rc-earnest/BloodHound/RemoteTest/Universal Remote Control Test Software/Universal Remote Control Test Software/Resources/URC Case-1.png

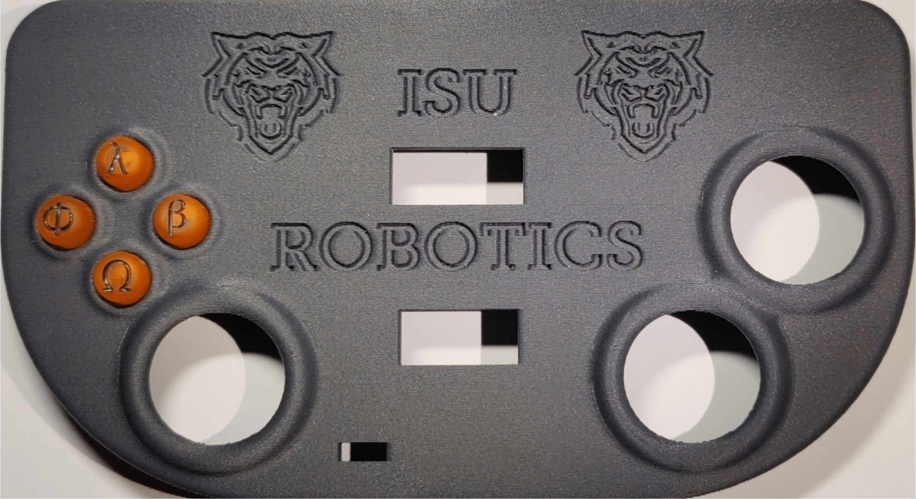
RemoteTest/Universal Remote Control Test Software/Universal Remote Control Test Software/Resources/URC Case-1.png
