rc-earnest/BloodHound/RemoteTest/Universal Remote Control Test Software/Universal Remote Control Test Software/Resources/URC PCB-1.png

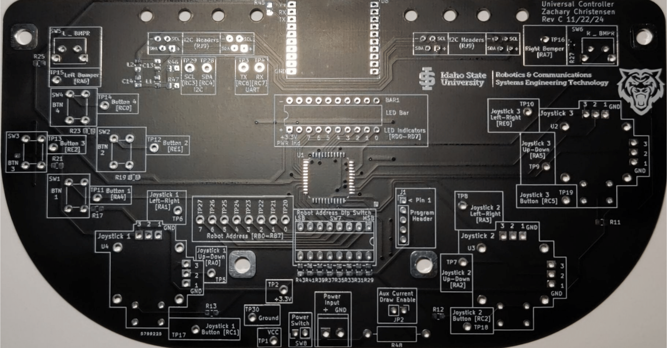
RemoteTest/Universal Remote Control Test Software/Universal Remote Control Test Software/Resources/URC PCB-1.png
