rc-earnest/BloodHound/README.md

Please read all of the READ files within the various folders as they may contain information as to what files you need to grab in the future.
