rc-earnest/BloodHound/Documents/Bloodhound_RCEV_Presentation.pptx

BloodHound RCEV

Remotely Controlled Electric Vehicle

Noah Holloway & Micah Spencer | ISU RCET Capstone | Spring 2026

[IMAGE: Bloodhound ATV photo]

## Slide 2

INTRODUCTION

What is the Bloodhound?

- A repurposed Kawasaki 450 ATV frame converted into a remotely controlled electric vehicle
- Designed to operate in hazardous environments — without putting a human operator at risk
- Powered by a 52V LiFePO4 battery with dual 48V brushless hub motors (front-wheel drive)
- Steering is handled by a DOCYKE power steering servo mounted directly to the steering column
- Built and tested in 8 weeks as an ISU RCET capstone project

[IMAGE: Bloodhound frame/hardware photo from lab]

[IMAGE: Bloodhound frame/hardware photo]

## Slide 3

HARDWARE

Hardware Overview

Vehicle Platform

- Kawasaki 450 frame, suspension & wheels
- 2× 48V brushless hub motors
- 2× 2-mode brushless speed controllers
- DOCYKE S350 power steering servo (12–18 Nm torque)

Electronics

- 52V LiFePO4 battery with BMS (30Ah)
- DC/DC converter: 52V → 24V for servo & boards
- 3 custom PCBs: URC, Master Main Board, Slave Dev Board
- All PIC16F1788 / PIC16LF1789 microcontrollers

[IMAGE: Photo of all 3 PCBs side by side, or mounted on vehicle panel]

## Slide 4

SYSTEM ARCHITECTURE

Three-Board Architecture

URC

Universal Remote Controller
PIC16LF1789 (44-pin)

MASTER

Master Main Board
PIC16F1788 (28-pin)

SLAVE

Slave Dev Board
PIC16F1788 (28-pin)

UART 115,200 bps Wireless

I2C 100 kHz Wired

Outputs from Slave Board:

PWM → Motor Controllers

PWM → DOCYKE Servo (steering)

Brake & Direction signals

[IMAGE: Block diagram from report, or photo of wired boards together]

## Slide 5

COMMUNICATION

How Data Flows: URC → Master → Slave

- Step 1 — Operator moves joystick on the URC
Joystick position captured as 0–255 analog value; packaged into a 6-byte UART packet
- Step 2 — Packet travels over wireless UART at 115,200 bps to the Master board
Packet includes: sync byte (0x24), robot address, command type, and 3 data bytes
- Step 3 — Master decodes the packet and every 96ms sends I2C data to the Slave
I2C transaction: START → address (0x20) → 4 data bytes → ACK each → STOP
- Step 4 — Slave receives I2C bytes, interprets joystick values, and updates outputs
After all 4 bytes arrive, I2C_RX_COMPLETE flag triggers motor and servo updates

## Slide 6

COMMUNICATION DEEP DIVE

I2C Data Packets Explained

Byte 1

JOY1_UD

Drive Throttle
(Joystick 1 Up/Down)

Byte 2

JOY1_LR

Unused
(future use)

Byte 3

JOY2_UD

Brake trigger
(Joystick 2 Up/Down)

Byte 4

JOY2_LR

Steering
(Joystick 2 Left/Right)

How the values are interpreted:

- Each joystick axis arrives as a byte: 0 = full left/back, 128 = center, 255 = full right/forward
- Slave compares values to thresholds (Upper: 160, Lower: 80) to determine direction
- Values outside the deadband are mapped proportionally to motor duty cycle or servo position

## Slide 7

FIRMWARE DEEP DIVE

Slave Board: Data → Physical Action

- Timer 2 ISR fires every 0.1ms — the heartbeat of all output signals
Software PWM: counts ticks to generate precise pulse widths for servo and motor controllers
- Servo (DOCYKE): 50Hz signal, 1.2ms = full right, 1.5ms = center, 1.9ms = full left
- Motor controllers: PWM duty sets speed; separate direction and brake pins control mode
- Each I2C packet triggers UPDATE_DRIVE_STATUS → threshold check → set motor duty + servo
- No I2C for ~260ms? → I2C_COM_TIMEOUT fires → brakes engage, all outputs go to stop

[IMAGE: Oscilloscope screenshot of PWM signal on RA4 (servo) or RA0 (motor)]

## Slide 8

SAFETY

Built-In Safety: Two Watchdogs

UART Watchdog (Master)

- Timer 2 counts time between valid UART packets
- No packet in ~0.5 seconds → CONNECT_TIMEOUT
- Triggers a controller disconnect routine
- Protects against loss of wireless signal

I2C Watchdog (Slave)

- Timer 1 counts time between I2C data packets
- No packet in ~260ms → I2C_COM_TIMEOUT
- Immediately engages brakes and stops all motors
- Prevents runaway if Master board fails

[IMAGE: Oscilloscope capture showing brake signal asserting after cable pull]

## Slide 9

RESULTS

What We Achieved

- Reliable wireless UART communication between URC and Master board
- Full I2C communication chain: Master → Slave, 4-byte packets at 96ms intervals
- Joystick-controlled forward and reverse drive on both hub motors
- Proportional steering via DOCYKE servo responding to joystick input
- Electronic braking — I2C timeout automatically engages brakes within 260ms
- System recovers automatically when connection is restored (no reboot needed)
- RTK GPS module started — partially functional (requires further tuning)

[IMAGE: Bloodhound being driven in the lab — action shot if available]

## Slide 10

CONCLUSION

Future Expansion & Takeaways

Planned Additions

- Front camera + backup camera (auto-switch on reverse)
- Remotely-controlled headlights via button on URC
- IMU / accelerometer for orientation data
- LiDAR for obstacle detection
- Chemical sensors: CO and CO2 detection
- RTK GPS for precise positioning

Key Takeaways

- Modular architecture — adding new slave boards is simple by design
- Hardware bugs (missing MOSFETs, wrong T2CON) can look like firmware issues
- Version control matters — working code was lost to an external tool and had to be restored
- A structured troubleshooting procedure saved significant time

Thank you — Questions?
