rc-earnest/BloodHound/Documents/Drive Report and Presentation/Bloodhound_RCEV_Presentation.pdf

# BloodHound RCEV

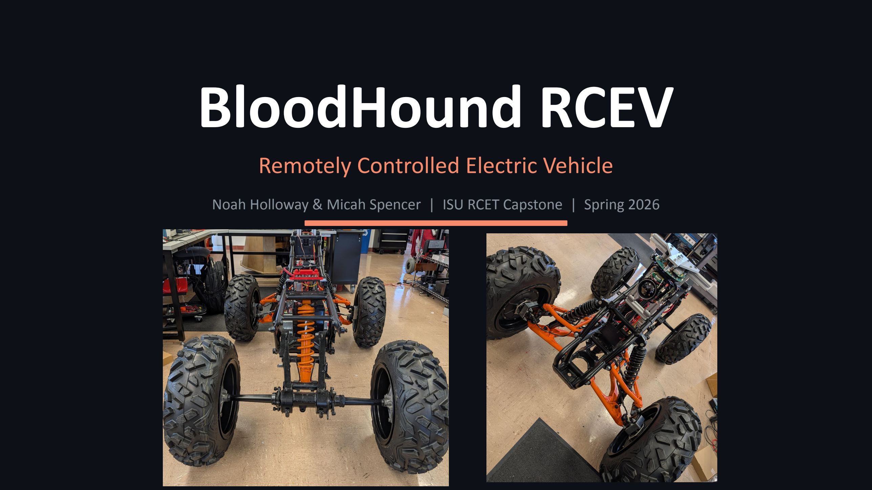
[picture p3: page 1]

## Remotely Controlled Electric Vehicle

Noah Holloway & Micah Spencer | ISU RCET Capstone | Spring 2026

# What is the Bloodhound?

- A repurposed Kawasaki 450 ATV frame converted into a Remotely Controlled Electric Vehicle (RCEV)
- Designed to operate in hazardous environments without putting a human operator at risk
- Powered by a 52V LiFePO4 battery with dual 48V brushless hub motors (front-wheel drive)
- Steering is handled by a DOCYKE power steering servo mounted directly to the steering column

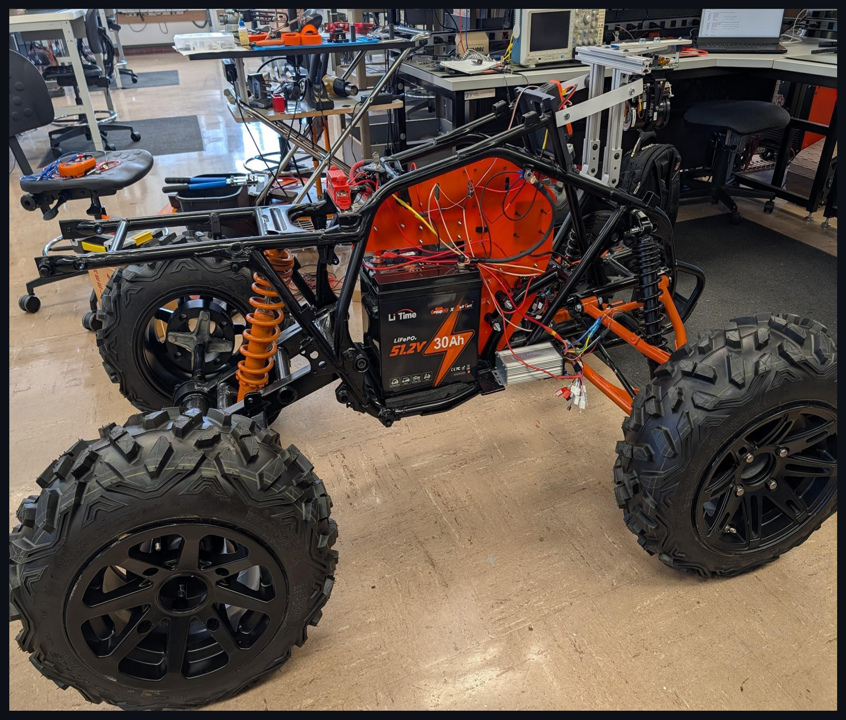
[picture p4: figure]

[IMAGE: Bloodhound frame/hardware photo from lab]

# Hardware Overview

Vehicle Platform
- Kawasaki 450 frame, suspension & wheels

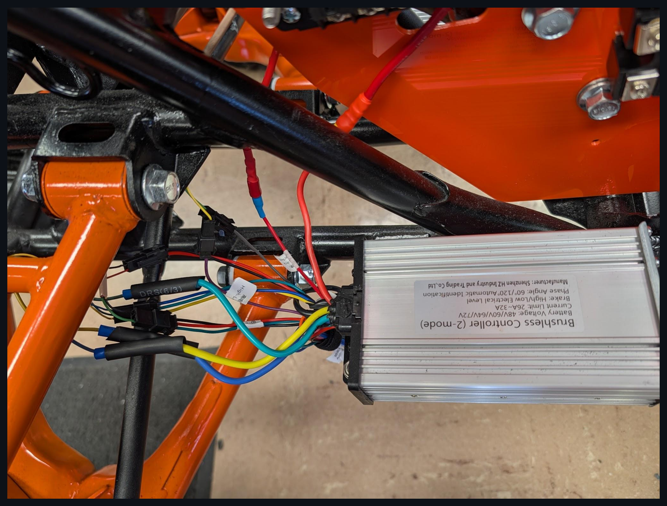
[picture p5: figure]

- 2× 48V brushless hub motors
- 2× 2-mode brushless speed controllers
- DOCYKE S350 power steering servo

Electronics
- 52V LiFePO4 battery (30Ah)
- DC/DC converter: 52V → 24V for servo & 5V step

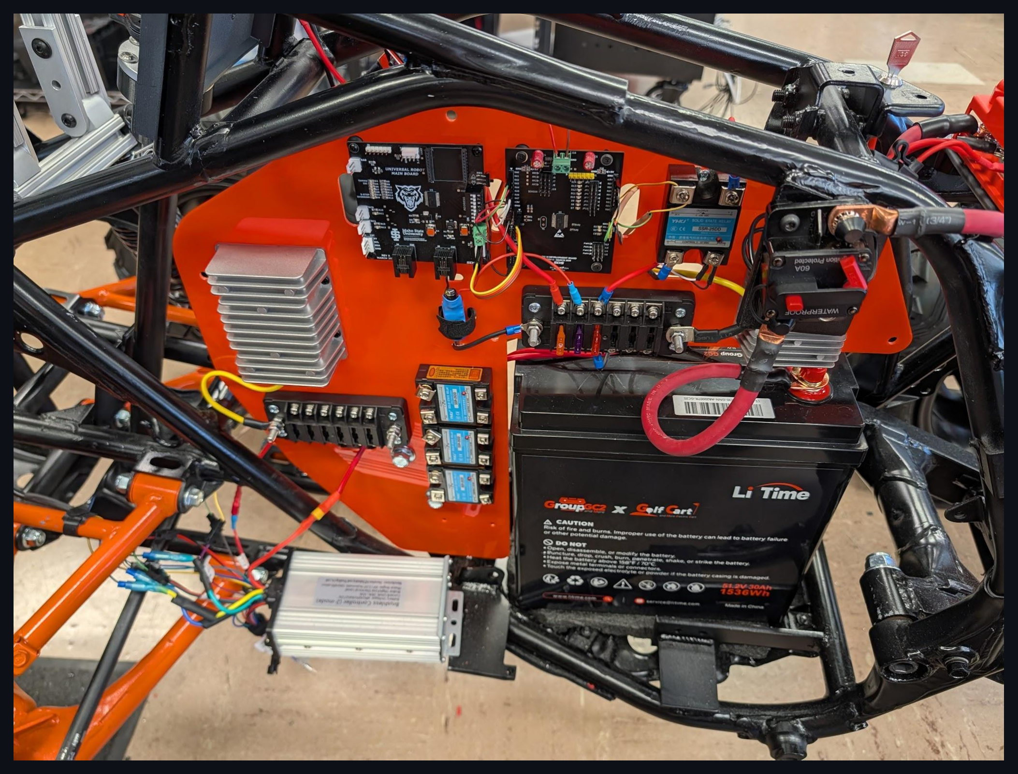
[picture p6: figure]

- DC/DC converter: 52V → 12V for headlights
- 3 custom PCBs: URC, Master Main Board, Slave Dev Board
- All PIC16F1788 / PIC16LF1789 microcontrollers

# RTK Hardware

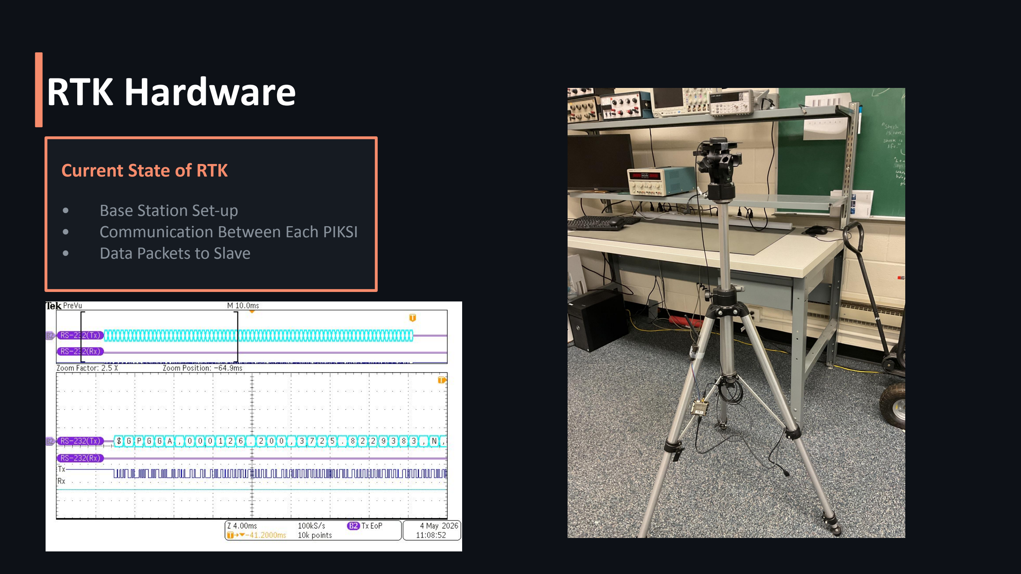
[picture p7: page 4]

Current State of RTK

- Base Station Set-up
- Communication Between Each PIKSI
- Data Packets to Slave

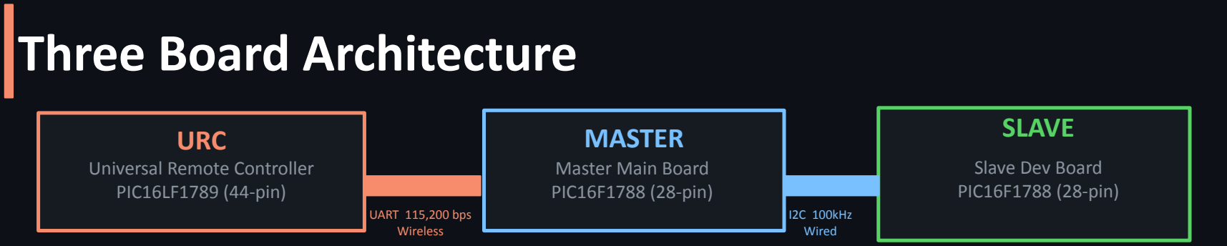
[picture p8: figure]
Three Board Architecture; URC; Universal Remote Controller PIC16LF1789 (44-pin); MASTER; Master Main Board PIC16F1788 (28-pin); SLAVE; Slave Dev Board PIC16F1788 (28-pin); UART 115,200 bps Wireless; I2C 100kHz Wired
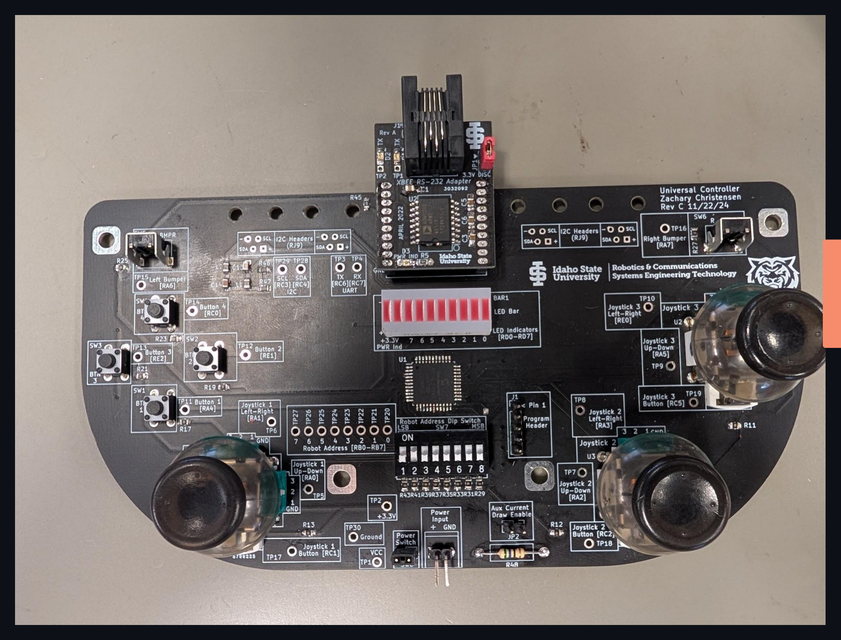
[picture p9: figure]

Outputs from Slave Board:

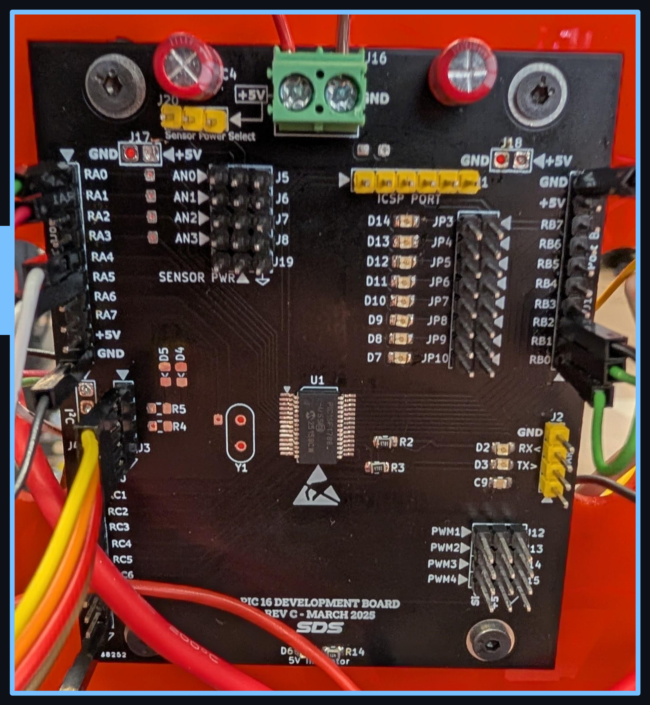
[picture p10: figure]
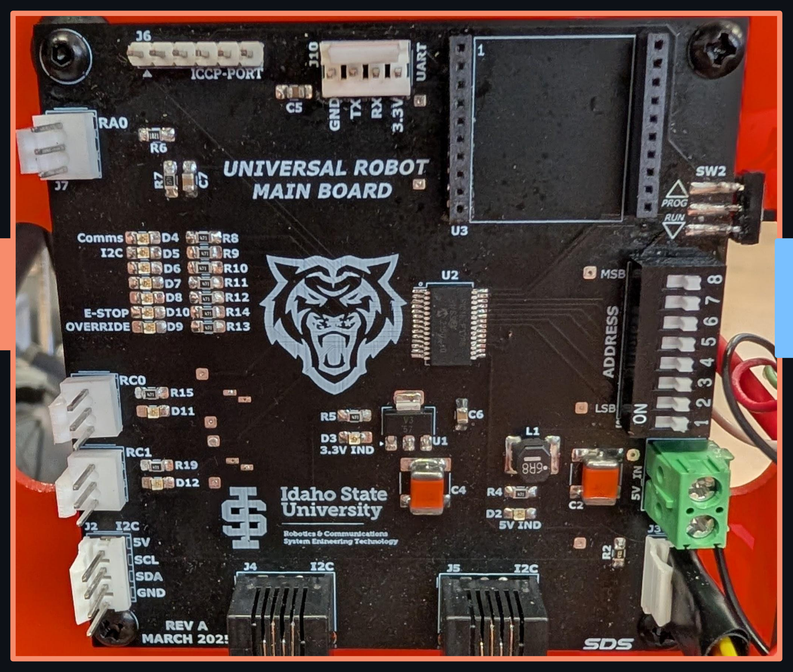
[picture p11: figure]

PWM → Motor Controllers | PWM → DOCYKE Servo (steering) | Brake & Direction signals

# Data Flow: URC → Master → Slave

- Step 1 — Operator moves joystick on the URC

Joystick position captured as 0–255 analog value; packaged into a 6 byte UART packet

- Step 2 — Packet travels over wireless UART at 115,200 bps to the Master board

Packet includes: sync byte (0x24), robot address, command type, and 3 data bytes

- Step 3 — Master decodes the packet and every 96ms sends I2C data to the Slave

I2C transaction: START → address (0x20) → 4 data bytes → ACK each → STOP

- Step 4 — Slave receives I2C bytes, interprets joystick values, and updates outputs

After all 4 bytes arrive, I2C_RX_COMPLETE flag triggers motor and servo updates

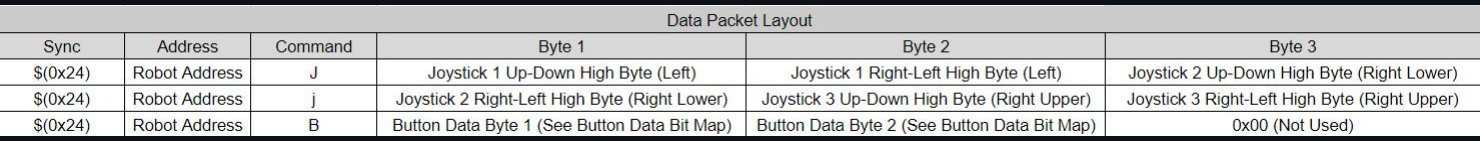
[picture p12: figure]

Data Packet Layout Credit: Zac Christensen

# I2C Data Packets Explained

Byte 1

JOY1_UD

Drive Throttle
(Joystick 1 Up/Down)

Byte 2

JOY1_LR

Unused
(future use)

Byte 3

JOY2_UD

Brake trigger
(Joystick 2 Up/Down)

Byte 4

JOY2_LR

Steering
(Joystick 2 Left/Right)

How the values are interpreted:

- Each joystick axis arrives as a byte: 0 = full left/back, 128 = center, 255 = full right/forward
- Slave compares values to thresholds (Upper: 160, Lower: 80) to determine direction
- Servo PWM (full right= 1.2ms, center=1.5ms, full left=1.9ms)
- Values outside the deadband are mapped proportionally to motor duty cycle or servo position

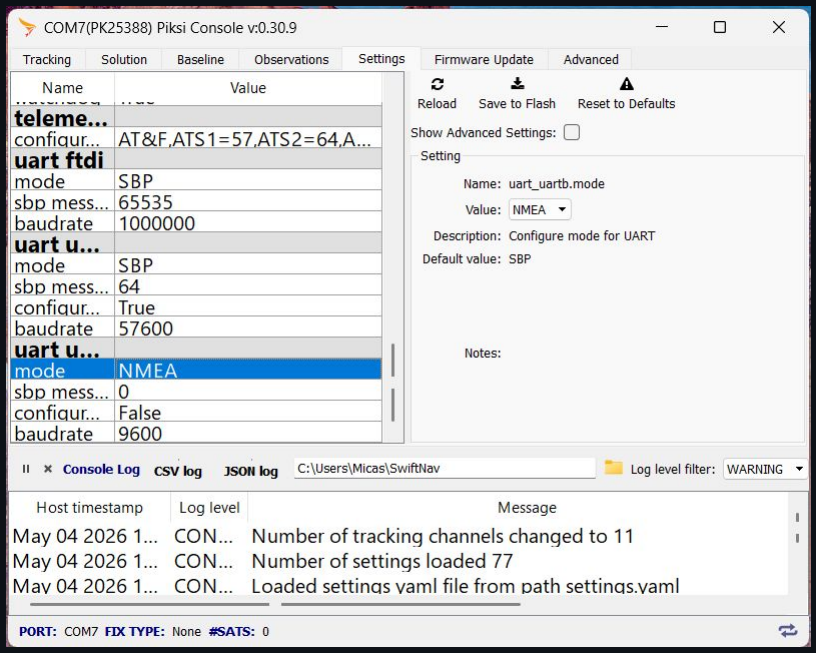
[picture p13: figure]

# RTK Software

Software Requirements:

- Swift Navigation Piksi Console
- Piksi-Piksi Communication: SBP @ 57600
- Piksi-Slave Communication: NMEA @ 9600

# Safety

BloodHound Hardware

- In-line fuses for 24V & 12V hubs
- In-line key switch disengaging speed controllers
- In-line Battery Pos Terminal kill switch

I2C Watchdog (Slave)

- Timer 1 counts time between I2C data packets
- No packet in ~260ms → I2C_COM_TIMEOUT

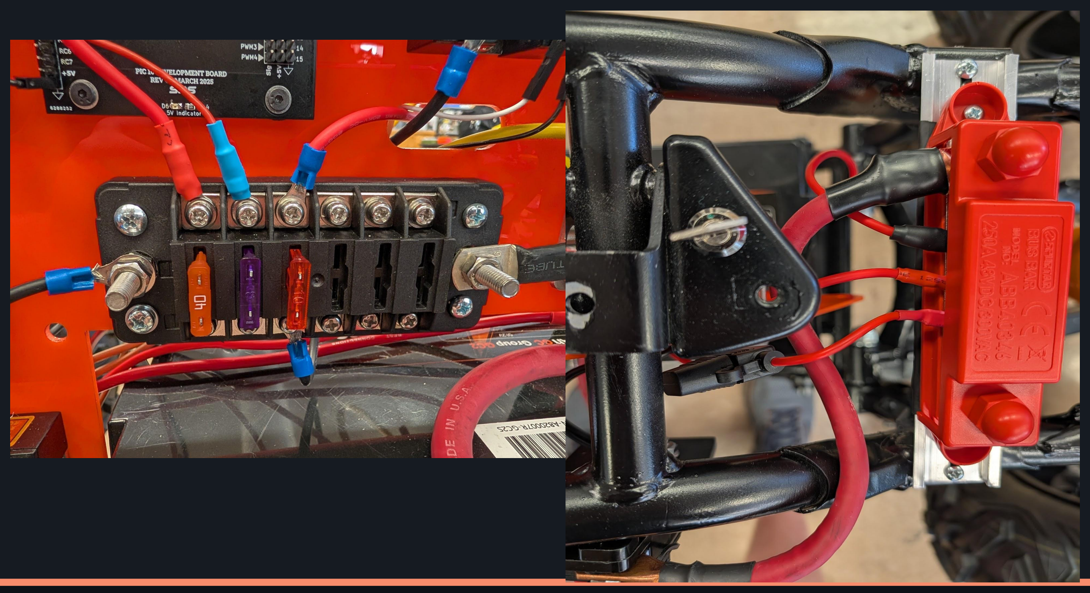
[picture p14: figure]

- Immediately engages brakes and stops all motors
- Prevents runaway if Master board fails

# Achievements

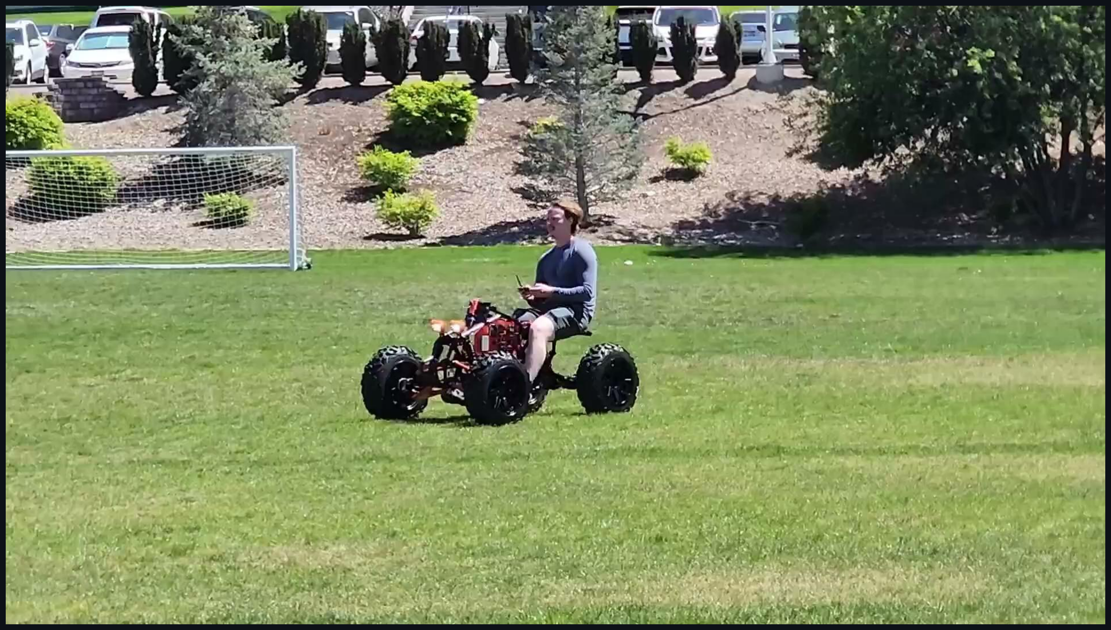
[picture p15: figure]

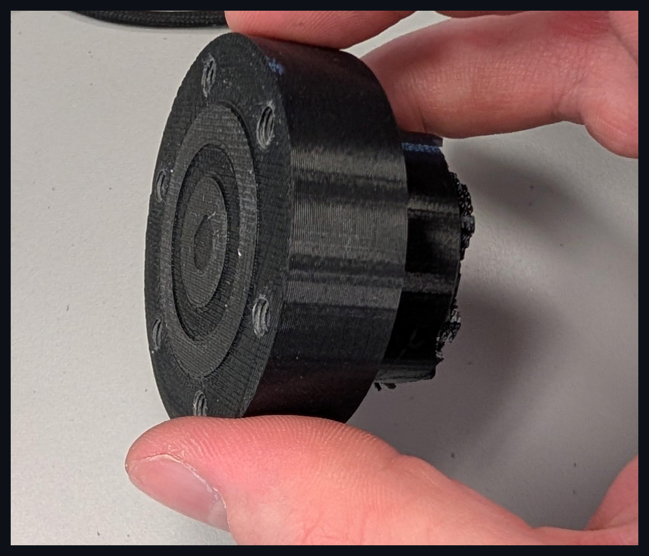
[picture p16: figure]

# Complications

- Broke multiple DOCYKE servos during testing
- Broke DOCYKE servo plastic coupler (twice)
- RTK Communication between Piksi and Slave Board

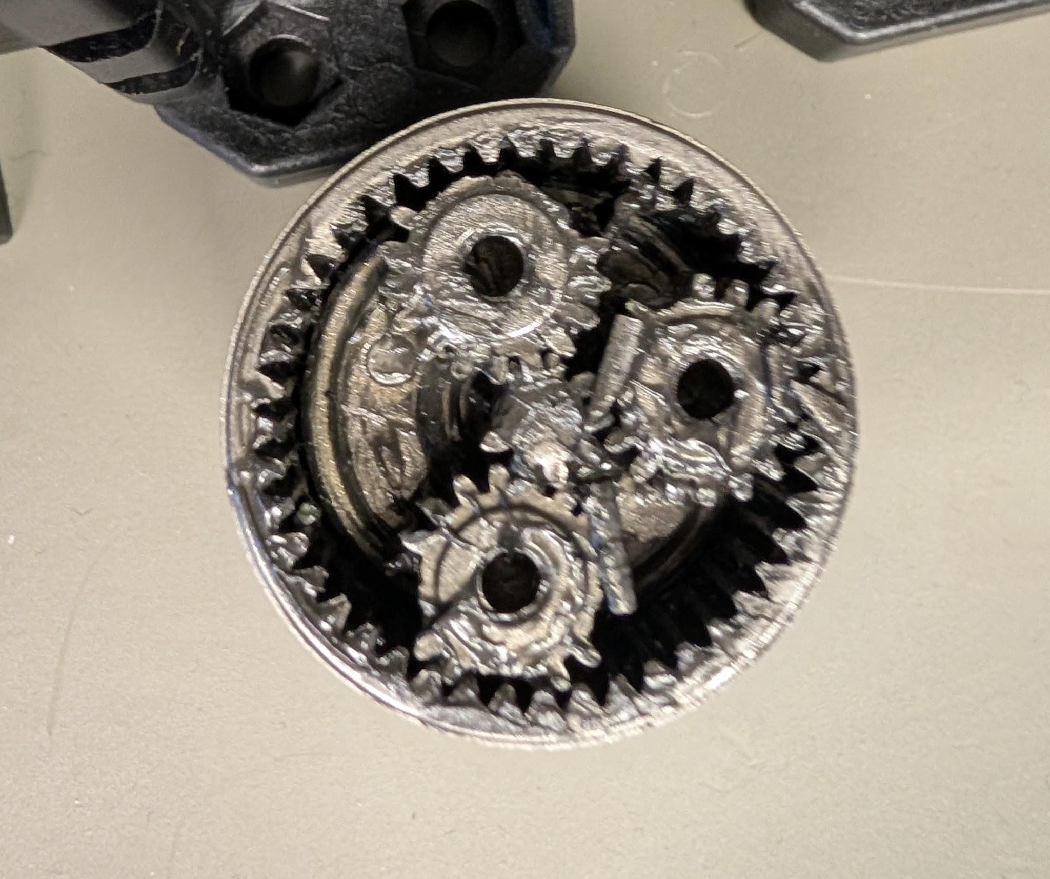
[picture p17: figure]

# Cost Analysis

Team Member | Hours/ day | Total Days | Total Hours | Cost/ hr | Total
Noah Holloway | ~5.5 | 31 | 170.5 | $50 | $8,525
Micah Spencer | ~4 | 10 | 40.5 | $50 | $2,025
Total | 9.5 | 41 | 211 | $10,550
Total + BOM | | | | $13,671.50

# Future Expansion

Planned Additions

- Backup camera & backup lights (automatically on reverse)
- Accelerometer for orientation data
- Chemical sensors (CO and CO2)

### Thank you — Questions?
