rc-earnest/BloodHound/Lidar/00_RESOURCES/YDLIDAR Driver Website Locations.pdf

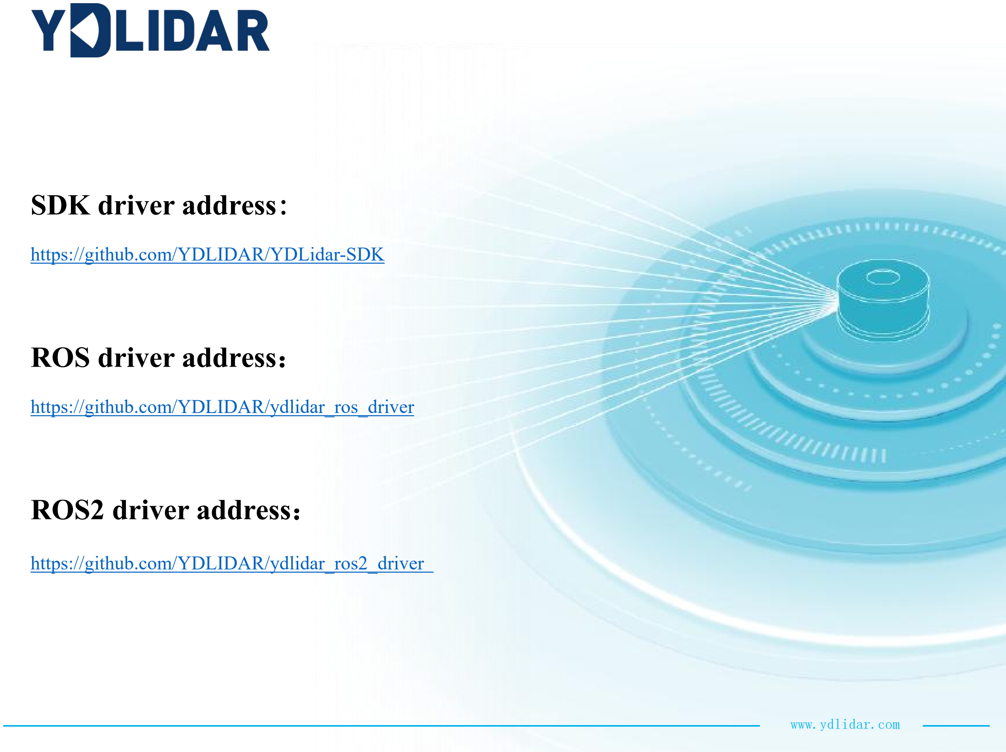
[picture p86: page 1]

www.ydlidar.com

## SDK driver address:

https://github.com/YDLIDAR/YDLidar-SDK

## ROS driver address：

https://github.com/YDLIDAR/ydlidar_ros_driver

## ROS2 driver address：

https://github.com/YDLIDAR/ydlidar_ros2_driver
