rc-earnest/BloodHound/Documents/Bloodhound_BOM (1).xlsx

BLOODHOUND RCEV — BILL OF MATERIALS
Idaho State University | RCET Capstone Project
# | Category | Item Description | Part / Source | Qty | Unit Cost (Est.) | Total Cost (Est.) | Notes
CHASSIS & MECHANICAL
1 |  | Kawasaki 450 ATV Frame (Facebook Marketplace) | Facebook Marketplace | 1 | $350.00 | $350.00 | Includes suspension, axles, wheels, steering column
3 |  | Front wheel hubs (modified for hub motors) | Custom / local fab | 2 | $25.00 | $50.00 | May require machining
4 |  | Steering linkage hardware / tie rods | Local hardware / OEM | 1 | $30.00 | $30.00 | Verify fitment with servo mount
5 |  | DOCYKE Power Steering Servo Motor | DOCYKE S350 | 3 | $120.00 | $360.00 | Mounted to steering column; PWM controlled
6 |  | Servo mounting bracket (custom fabricated) | Custom fab / 3D print | 1 | $20.00 | $20.00 | Mounts servo to steering column
7 |  | Assorted fasteners (M4, M6, M8 screws/nuts/washers) | Amazon / local hardware | 1 | $18.00 | $18.00 | ~100 pc mixed kit
POWER SYSTEM
8 |  | 52V 30Ah LiFePO4 Battery Pack | Supplier / eBay | 1 | $420.00 | $420.00 | Main drive and system power
9 |  | BMS (integrated with battery pack) | Included with battery | 1 | $0.00 | $0.00 | 60A BMS per battery manual
10 |  | DC/DC Converter (30–60V in, 24V/10A out) | Amazon / AliExpress | 1 | $35.00 | $35.00 | Powers 24V logic rail
11 |  | High-current inline safety switch (main disconnect) | Amazon / EV Supply | 1 | $22.00 | $22.00 | Emergency shutoff on main 52V line
12 |  | 52V Power distribution bus bar | Amazon | 1 | $18.00 | $18.00 | Main positive bus for battery outputs
13 |  | Blade fuse holder + fuses (20A, 30A assorted) | Amazon | 1 | $12.00 | $12.00 | Inline protection for each branch
14 |  | Anderson SB50 / XT90 battery connector | Amazon | 2 | $6.00 | $12.00 | Main battery disconnect connector
DRIVE SYSTEM
15 |  | 48V Brushless Hub Motor (front) | Supplier | 2 | $180.00 | $360.00 | Dual front-wheel drive; 48V nominal
16 |  | 48V Brushless Speed Controller (2-mode, 60A) | Supplier / AliExpress | 2 | $65.00 | $130.00 | Per spec: 48/60/64/72V, 26–32A current limit
17 |  | Throttle signal potentiometer / hall sensor | Amazon / AliExpress | 1 | $12.00 | $12.00 | 0–5V throttle signal to speed controller
18 |  | Reverse gear relay / logic circuit | Amazon | 1 | $8.00 | $8.00 | Activates reverse gear signal on controller
CONTROL ELECTRONICS / PCBs
19 |  | Universal Remote Controller PCB (PIC16LF1789, custom) | Custom fab / JLCPCB | 1 | $115.00 | $115.00 | 44-pin DIP; URC transmitter board
20 |  | Master Main Board PCB (PIC16F1788, custom) | Custom fab / JLCPCB | 1 | $50.00 | $50.00 | 28-pin; UART RX, I2C master
21 |  | Slave Development Board PCB (PIC16F1788, custom) | Custom fab / JLCPCB | 1 | $25.00 | $25.00 | 28-pin; I2C slave, PWM servo output
 |  | Xbee Pro Board PCB |  | 2 | $45.00 | $90.00 | UART to UART transmitter/ receiver
22 |  | PIC16LF1789 Microcontroller (URC) | Microchip / Digi-Key | 1 | $6.50 | $6.50 | 44-pin DIP package
23 |  | PIC16F1788 Microcontroller (Master) | Microchip / Digi-Key | 1 | $5.50 | $5.50 | 28-pin DIP package
24 |  | PIC16F1788 Microcontroller (Slave) | Microchip / Digi-Key | 1 | $5.50 | $5.50 | 28-pin DIP package
25 |  | MOSFET I2C level shifter (BSS138 or equiv.) | Digi-Key / Mouser | 4 | $0.50 | $2.00 | SCL/SDA voltage translation 3.3V–5V
26 |  | Decoupling capacitors (0.1uF, 10uF assorted) | Digi-Key | 1 | $4.00 | $4.00 | Bulk order; bypass caps per PCB
27 |  | Crystal oscillators / resonators (if needed) | Digi-Key | 2 | $1.50 | $3.00 | Slave & Master uses internal OSC
28 |  | DIP switches (address select, 4-pos) | Amazon / Digi-Key | 2 | $2.50 | $5.00 | I2C address selection on slave boards
29 |  | Indicator LEDs (D4, D5 debug; assorted colors) | Amazon | 10 | $0.25 | $2.50 | Debug and status LEDs on PCBs
30 |  | Current limiting resistors (330Ω, 1kΩ, 10kΩ assorted) | Amazon / Digi-Key | 1 | $5.00 | $5.00 | LED limiting, pull-ups, etc.
31 |  | Pin headers / IDC connectors (2.54mm, assorted) | Amazon | 1 | $8.00 | $8.00 | PCB interconnects and programming headers
32 |  | PIC programmer (PICkit 4 or equiv.) | Microchip Direct | 1 | $75.00 | $75.00 | Assumed available; include if not yet purchased
COMMUNICATION
33 |  | UART wireless transceiver module (915MHz or 2.4GHz) | Amazon / AliExpress | 2 | $18.00 | $36.00 | One per end; URC TX and Master board RX
34 |  | Piksi v.2.3.1 RTK Module Kit | Ebay | 2 | $499.00 | $998.00 | Discontinued in 2017; may need to find alternative
WIRING & CONNECTORS
35 |  | 16 AWG stranded wire (~10 ft, red/black) | Amazon / Home Depot | 10 | $0.50 | $5.00 | General power wiring, motor signal runs
36 |  | 4 AWG battery cable (~4 ft, red/black) | Amazon / EV Supply | 4 | $3.50 | $14.00 | High-current battery to controller runs
37 |  | 22 AWG stranded wire (~5 ft, assorted colors) | Amazon | 5 | $0.40 | $2.00 | PCB signal wiring, relay control
38 |  | JST connectors (various, ~10 total) | Amazon | 10 | $0.75 | $7.50 | PCB and sensor interconnects
39 |  | Ring terminals / butt connectors (assorted) | Amazon | 1 | $8.00 | $8.00 | Battery and high-current terminations
40 |  | Heat shrink tubing (assorted sizes) | Amazon | 1 | $6.00 | $6.00 | Wire insulation and strain relief
41 |  | Cable ties / zip ties (100 pc bag) | Amazon | 1 | $5.00 | $5.00 | Wire management
42 |  | Wire loom / braided sleeve (~6 ft) | Amazon | 1 | $8.00 | $8.00 | Protection and organization of wire runs
LIGHTING
43 |  | LED headlights (12V or 24V, 2-pack) | Amazon | 1 | $18.00 | $18.00 | Front-facing; powered from 24V rail via relay
44 |  | Relay module for headlight control (5V trigger) | Amazon | 1 | $6.00 | $6.00 | Logic-level control from Master board
45 |  | LED indicator / brake lights (rear) | Amazon | 1 | $12.00 | $12.00 | Optional; rear visibility
ENCLOSURES & MOUNTING
46 |  | PCB enclosure / electronics mounting tray | Amazon / 3D print | 1 | $20.00 | $20.00 | Protects electronics from vibration and weather
47 |  | Battery mounting tray / strap kit | Custom fab / Amazon | 1 | $25.00 | $25.00 | Secures 52V pack to frame
48 |  | Speed controller mounting hardware | Local hardware | 2 | $5.00 | $10.00 | Aluminum angle or bracket per controller
49 |  | Vibration-damping standoffs (M3/M4) | Amazon | 1 | $7.00 | $7.00 | PCB isolation from frame vibration
50 |  | Tripod | Amazon | 1 | $30.00 | $30.00 | For use as Piksi Base Station
ESTIMATED GRAND TOTAL |  |  |  |  |  | $3476.50
