rc-earnest/BloodHound/Camera/CameraSlave_KiCad/ThermalCamera.step

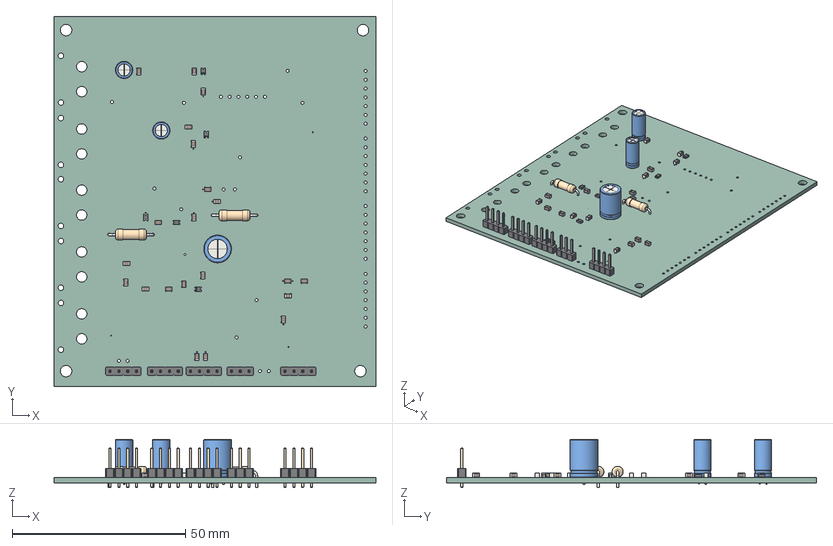
[picture p87: CAD file, 2026-04-30]
Camera/CameraSlave_KiCad/ThermalCamera.step
93.0 x 107.0 x 14.0 mm
PinHeader_1x03_P2.54mm_Vertical
D_0805_2012Metric x 5
C_0805_2012Metric x 21
PinHeader_1x04_P2.54mm_Vertical x 4
C_Radial_D5.0mm_H11.0mm_P2.00mm x 2
R_Axial_DIN0309_L9.0mm_D3.2mm_P12.70mm_Horizontal x 2
C_Radial_D8.0mm_H11.5mm_P3.50mm
ThermalCamera_PCB
