rc-earnest/BloodHound/GPS/Setup/PIKSI1.png

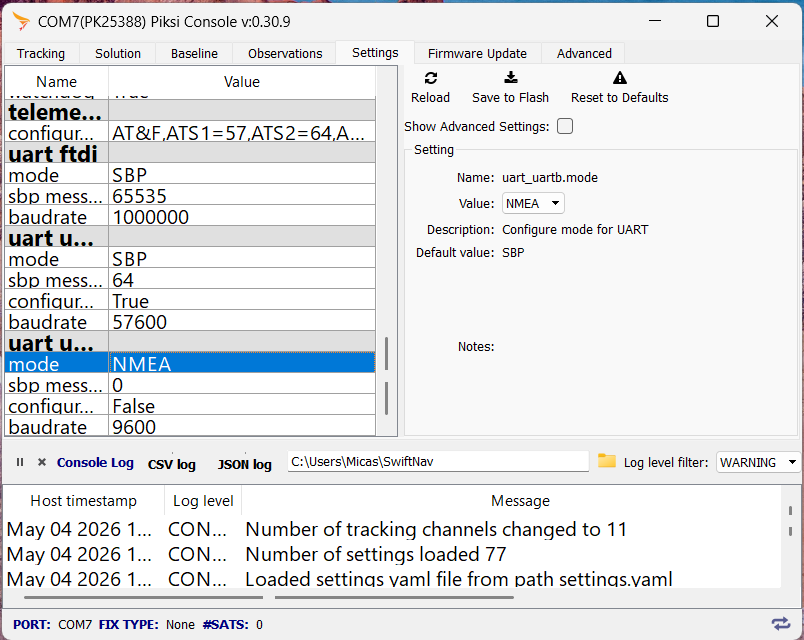
GPS/Setup/PIKSI1.png
