rc-earnest/BloodHound/GPS/Setup/PIKSI2.png

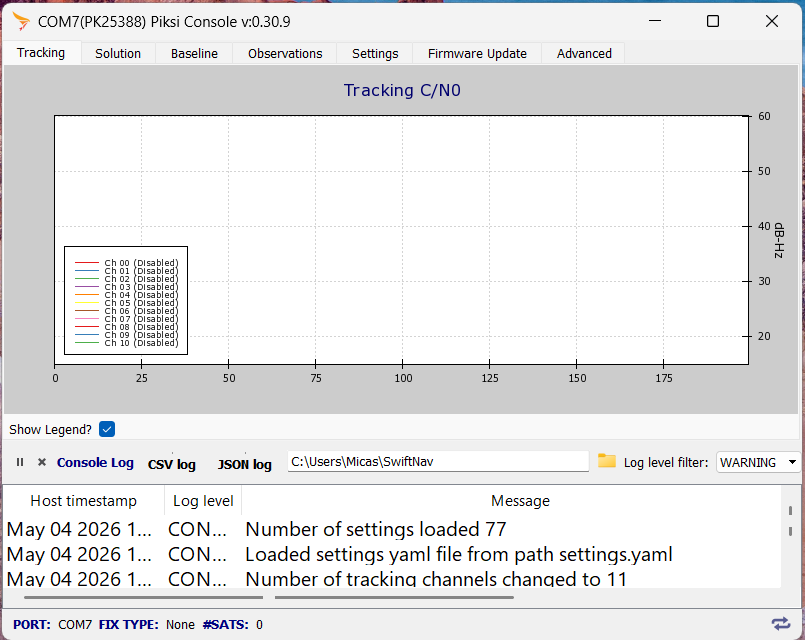
GPS/Setup/PIKSI2.png
