rc-earnest/BloodHound/GPS/Setup/PIKSI3.png

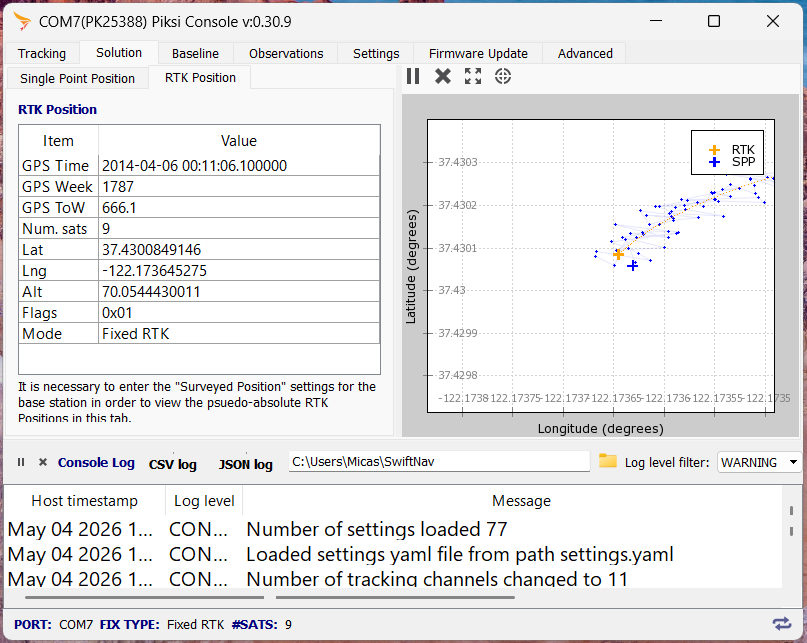
GPS/Setup/PIKSI3.png
