rc-earnest/BloodHound/GPS/Measurements/BLOODHOUND PIKSI Measurements (1).png

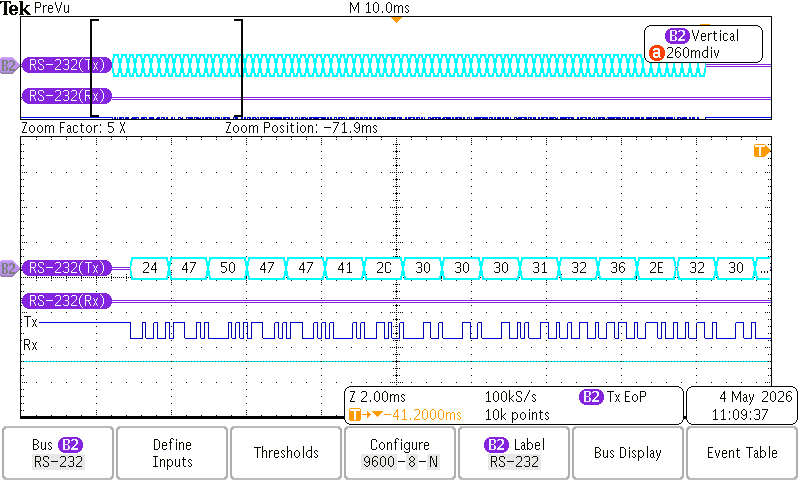
GPS/Measurements/BLOODHOUND PIKSI Measurements (1).png
