rc-earnest/BloodHound/GPS/Measurements/BLOODHOUND PIKSI Measurements (2).png

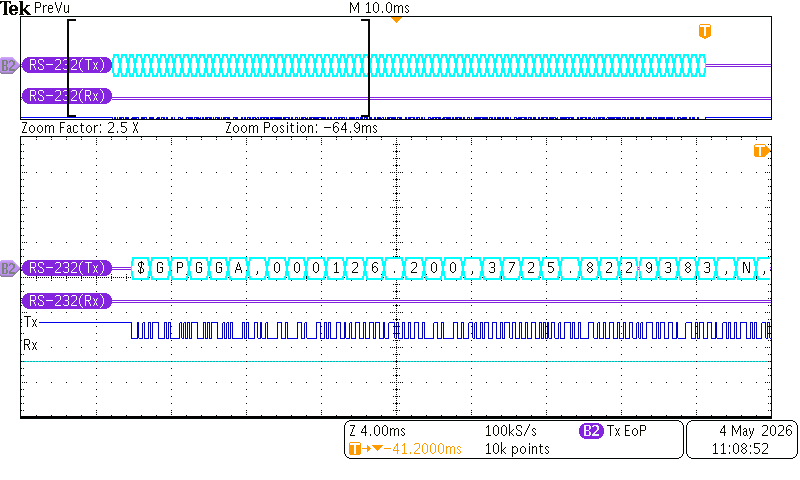
GPS/Measurements/BLOODHOUND PIKSI Measurements (2).png
