rc-earnest/BloodHound/GPS/Measurements/BLOODHOUND PIKSI Measurements (3).png

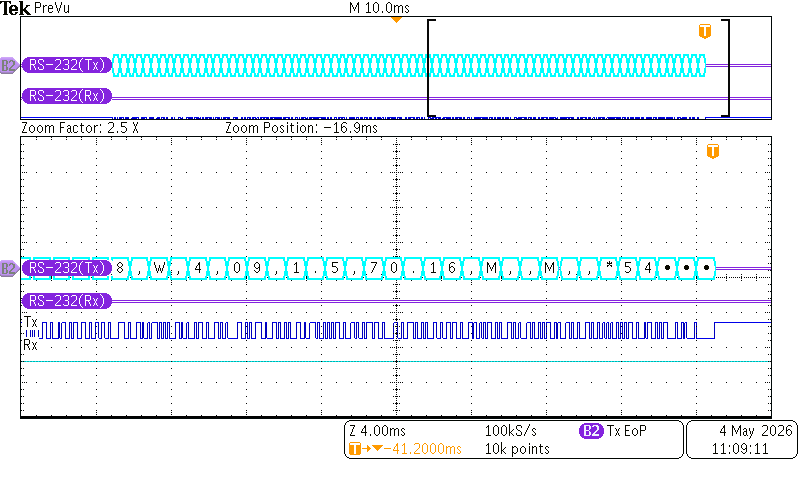
GPS/Measurements/BLOODHOUND PIKSI Measurements (3).png
