rc-earnest/BloodHound/GPS/Measurements/BLOODHOUND PIKSI Measurements (4).png

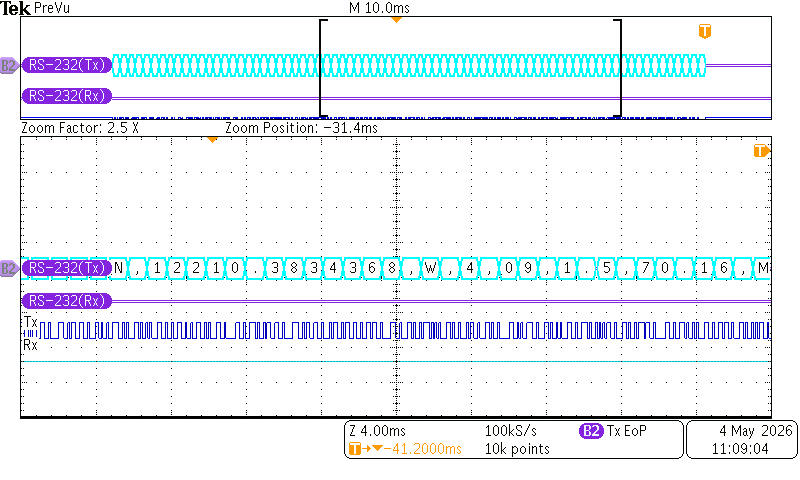
GPS/Measurements/BLOODHOUND PIKSI Measurements (4).png
