rc-earnest/BloodHound/GPS/Measurements/BLOODHOUND PIKSI Measurements (5).png

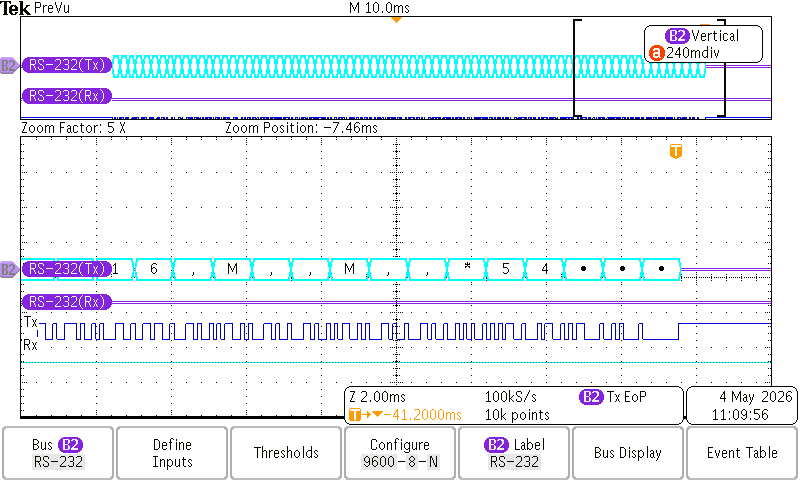
GPS/Measurements/BLOODHOUND PIKSI Measurements (5).png
