rc-earnest/BloodHound/GPS/Measurements/BLOODHOUND PIKSI Measurements (6).png

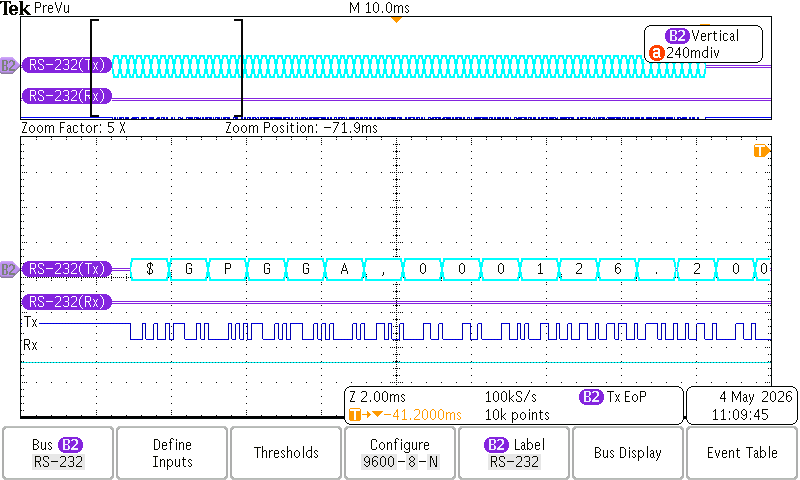
GPS/Measurements/BLOODHOUND PIKSI Measurements (6).png
