rc-earnest/BloodHound/Documents/Aux Sensors Report and Presentation/BloodhoundAuxSensorsPresentation.pdf

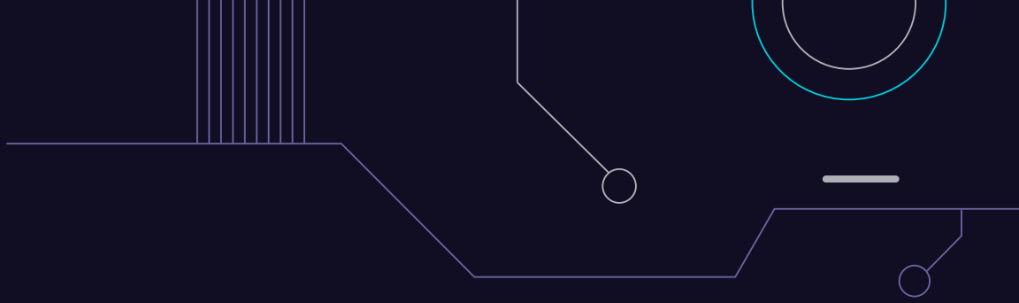
[picture p97: figure]
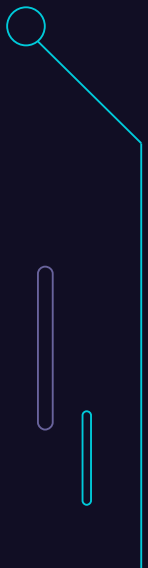
[picture p98: figure]

# Bloodhound Auxiliary Sensors

## By: Rudy Earnest and Jonas Cram

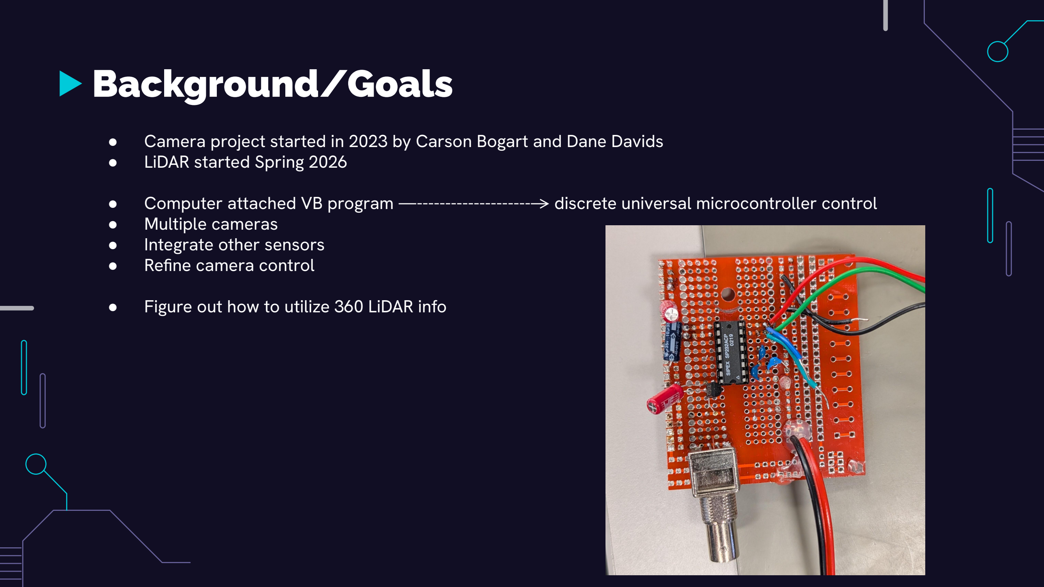
[picture p99: figure]
Background/Goals; ● LiDAR started Spring 2026; ● Multiple cameras ● Integrate other sensors ● Refine camera control

- Camera project started in 2023 by Carson Bogart and Dane Davids
- Computer attached VB program —---------------------> discrete universal microcontroller control
- Figure out how to utilize 360 LiDAR info

# System

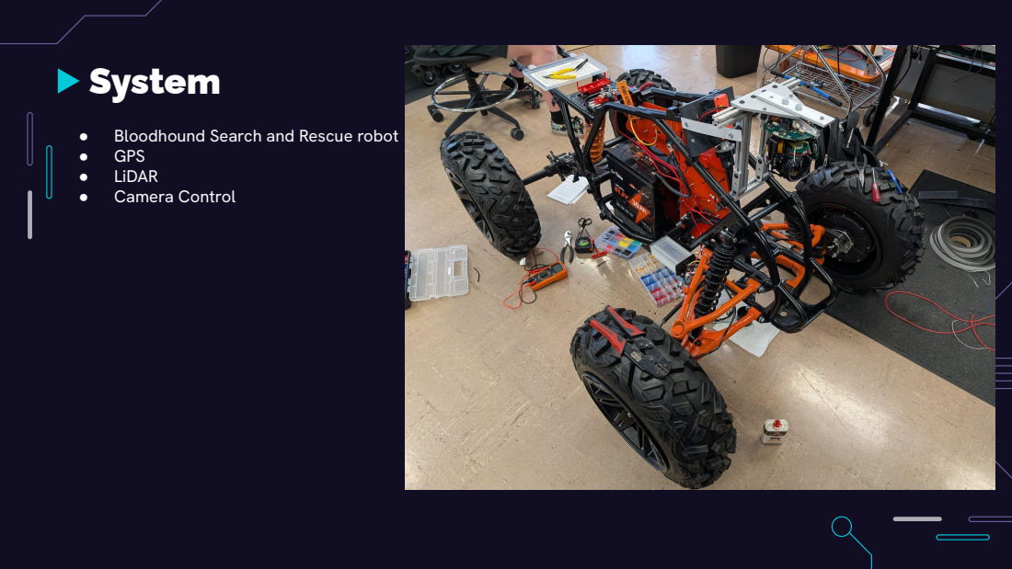
[picture p100: page 3]

● Bloodhound Search and Rescue robot ● GPS ● LiDAR ● Camera Control

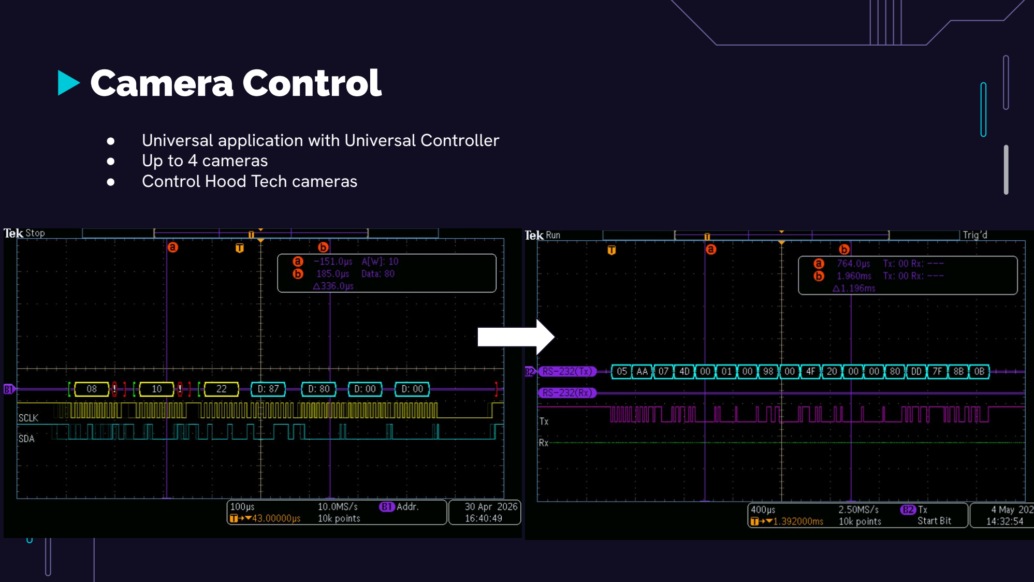
[picture p101: figure]
Camera Control; ● Up to 4 cameras ● Control Hood Tech cameras

- Universal application with Universal Controller

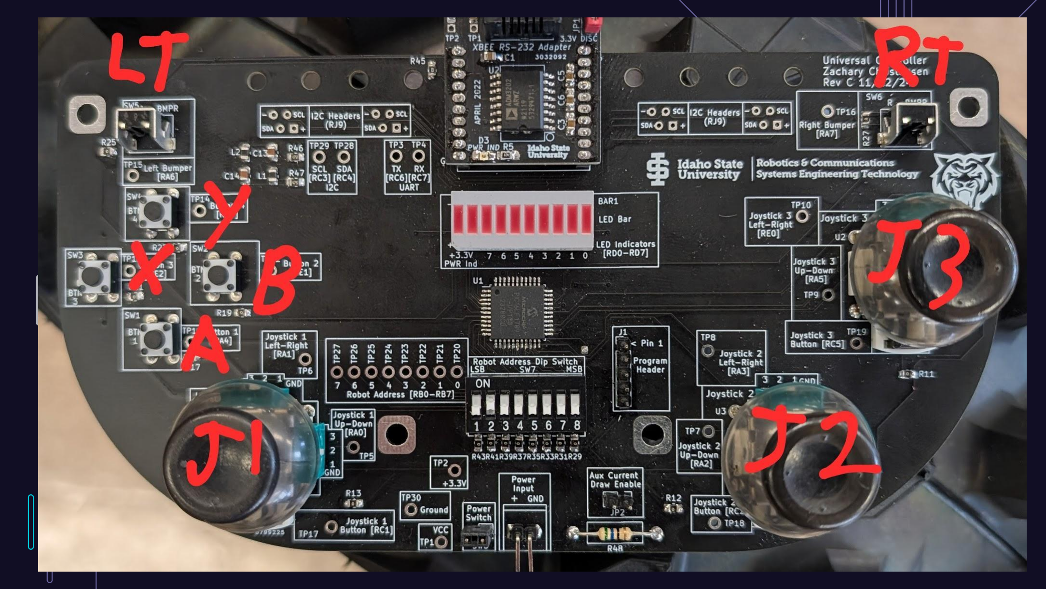
[picture p102: page 5]
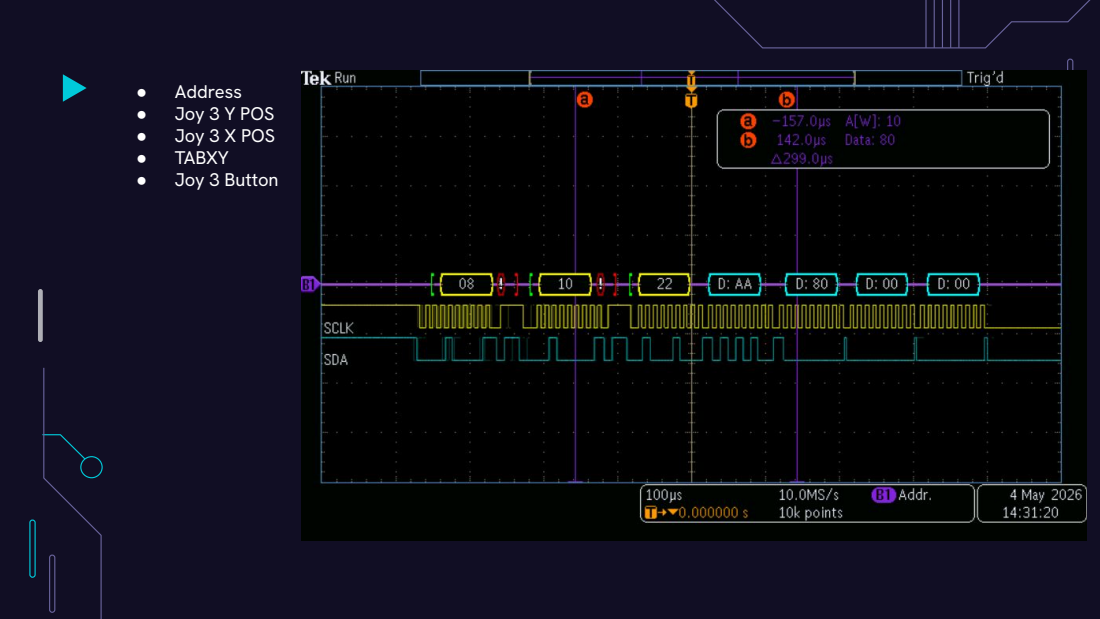
[picture p103: page 6]
● Address ● Joy 3 Y POS ● Joy 3 X POS ● TABXY ● Joy 3 Button

Command | Bytes Sent
Up .2 degrees | 55, AA, 07, 4D, 00, 01, 00, 98, 00, 47, 20, 00, 00, 80, DD, 7F, 8B, 0B
Up 1 degree | 55, AA, 07, 4D, 00, 01, 00, 98, 00, 47, 20, 00, 00, 80, 51, 7F, 4B, 6F
Up 5 degrees | 55, AA, 07, 4D, 00, 01, 00, 98, 00, 47, 20, 00, 00, 80, 97, 7C, EA, 7C
Down .2 degrees | 55, AA, 07, 4D, 00, 01, 00, 98, 00, 47, 20, 00, 00, 80, 23, 80, AB, 0B
Down 1 degree | 55, AA, 07, 4D, 00, 01, 00, 98, 00, 47, 20, 00, 00, 80, AF, 80, 6B, 6F
Down 5 degrees | 55, AA, 07, 4D, 00, 01, 00, 98, 00, 47, 20, 00, 00, 80, 69, 83, CA, 7C
Left .2 degrees | 55, AA, 07, 4D, 00, 01, 00, 98, 00, 47, 20, 00, DD, 7F, 00, 80, C7, 18
Left 1 degree | 55, AA, 07, 4D, 00, 01, 00, 98, 00, 47, 20, 00, 51, 7F, 00, 80, 57, 32
Left 5 degrees | 55, AA, 07, 4D, 00, 01, 00, 98, 00, 47, 20, 00, 97, 7C, 00, 80, DF, F3
Right .2 degrees | 55, AA, 07, 4D, 00, 01, 00, 98, 00, 47, 20, 00, 23, 80, 00, 80, 1F, 19
Right 1 degree | 55, AA, 07, 4D, 00, 01, 00, 98, 00, 47, 20, 00, AF, 80, 00, 80, 8F, 33
Right 5 degrees | 55, AA, 07, 4D, 00, 01, 00, 98, 00, 47, 20, 00, 69, 83, 00, 80, 07, FF
Zoom in | 55, AA, 07, 4D, 00, 01, 00, 98, 00, 5A, 01, 00, 00, 00, 01, 00, F3, D8
Zoom out | 55, AA, 07, 4D, 00, 01, 00, 98, 00, 5A, FF, 00, 00, 00, 01, 00, 2D, CD
Zoom stop | 55, AA, 07, 4D, 00, 01, 00, 98, 00, 5A, 00, 00, 00, 00, 00, 00, B2, DB
Video On | 55, AA, 07, 4D, 00, 01, 00, 98, 00, 7C, 00, 00, 00, 00, 00, 00, 70, 9F
Home | 55, AA, 07, 4D, 00, 01, 00, 98, 00, 47, 4A, 19, B8, 8B, 00, 80, 31, 53
Reset Camera | 55, AA, 07, 4D, 00, 01, 00, 98, 00, 47, FE, 00, 00, 00, 00, 00, 6D, 00
FFC/Adjust | 55, AA, 07, 4D, 00, 01, 00, 98, 00, 6D, 01, 03, 00, 00, 00, 00, A0, DB

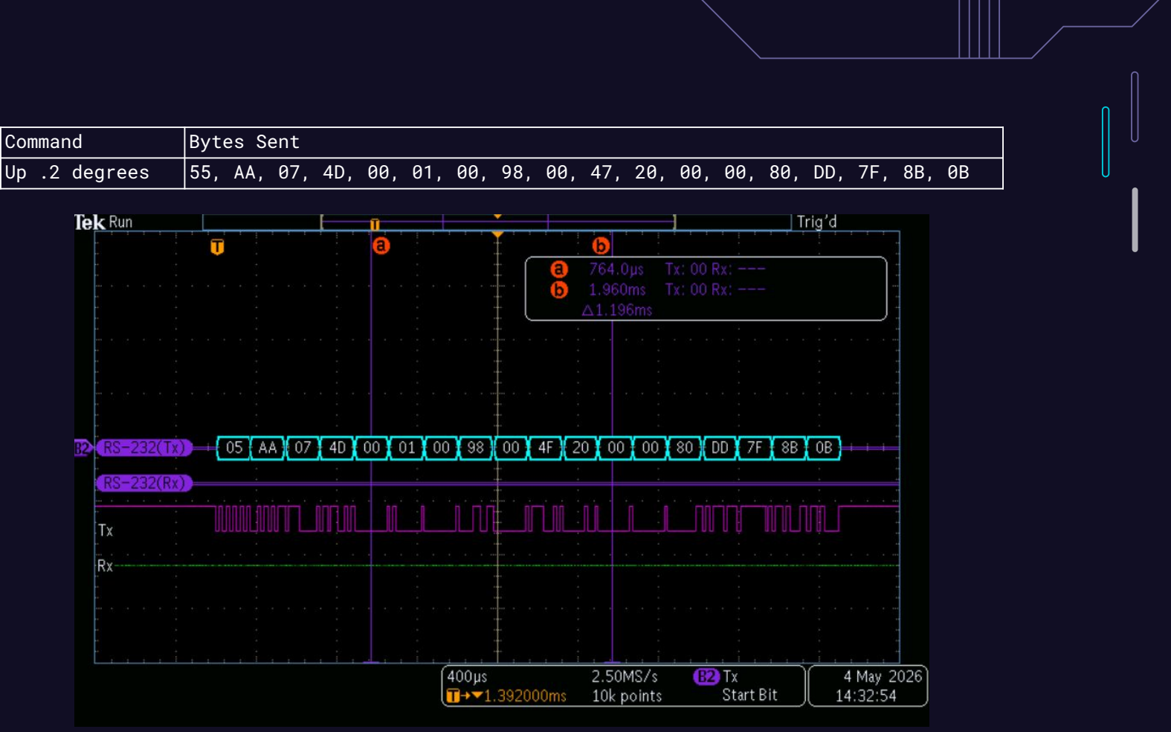
[picture p104: figure]
Command; Bytes Sent

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

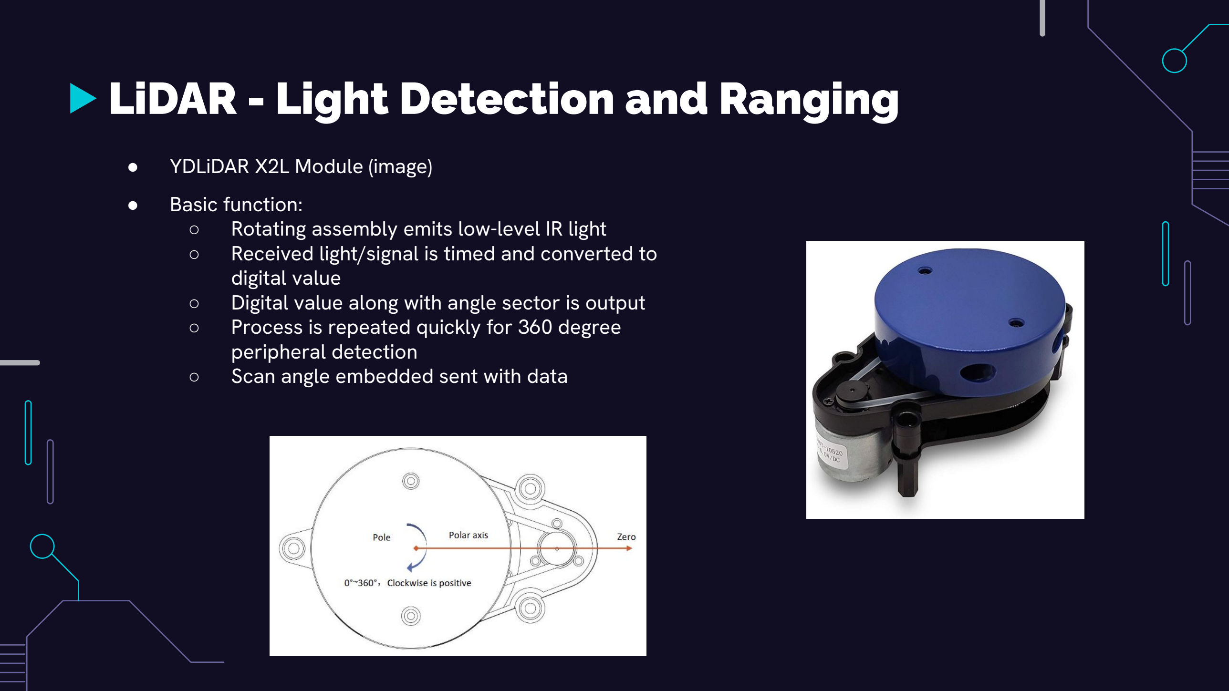
[picture p105: figure]
LiDAR - Light Detection and Ranging; ● YDLiDAR X2L Module (image) ● Basic function:; digital value; peripheral detection ○ Scan angle embedded sent with data

- Rotating assembly emits low-level IR light
- Received light/signal is timed and converted to
- Digital value along with angle sector is output
- Process is repeated quickly for 360 degree

# LiDAR Connections

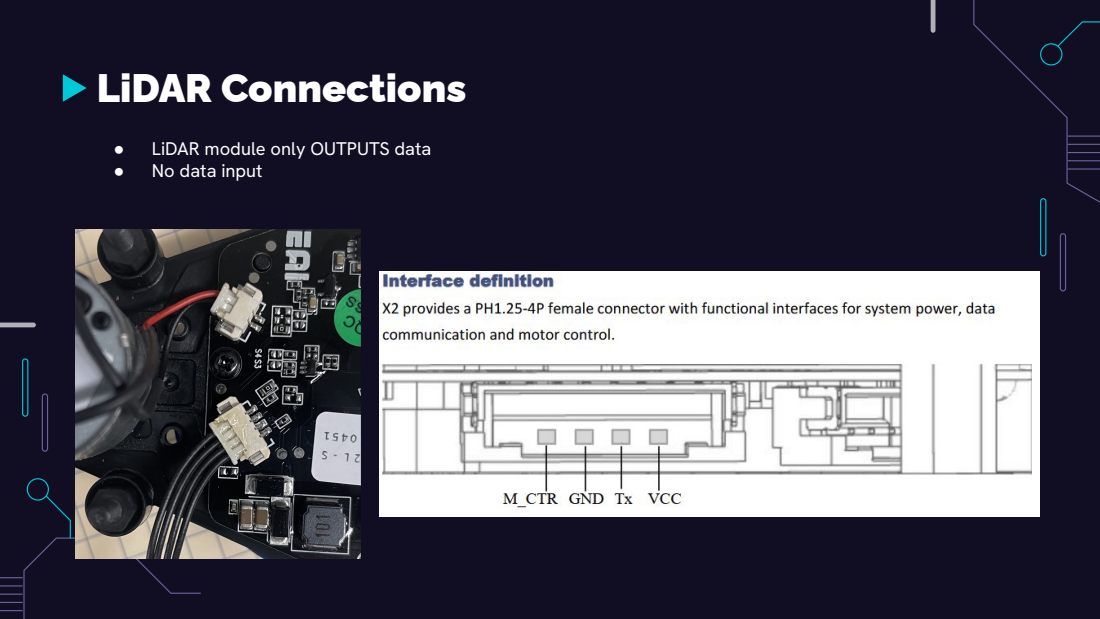
[picture p106: page 10]

● LiDAR module only OUTPUTS data
● No data input

# Reading LiDAR

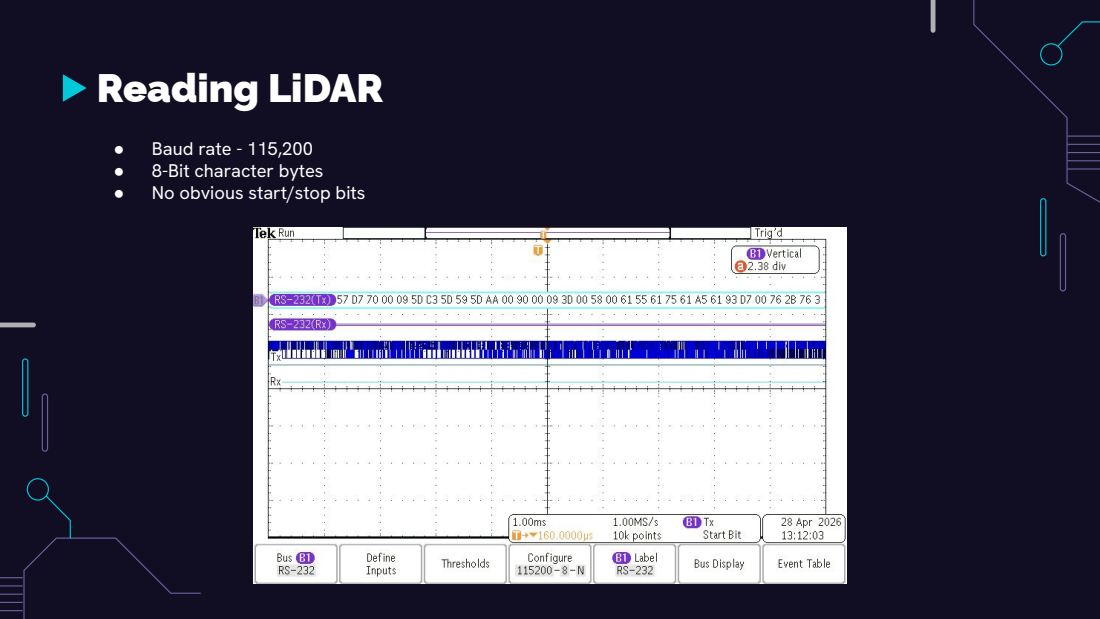
[picture p107: page 11]

● Baud rate - 115,200
● 8-Bit character bytes
● No obvious start/stop bits

# Deciphering LiDAR Packet

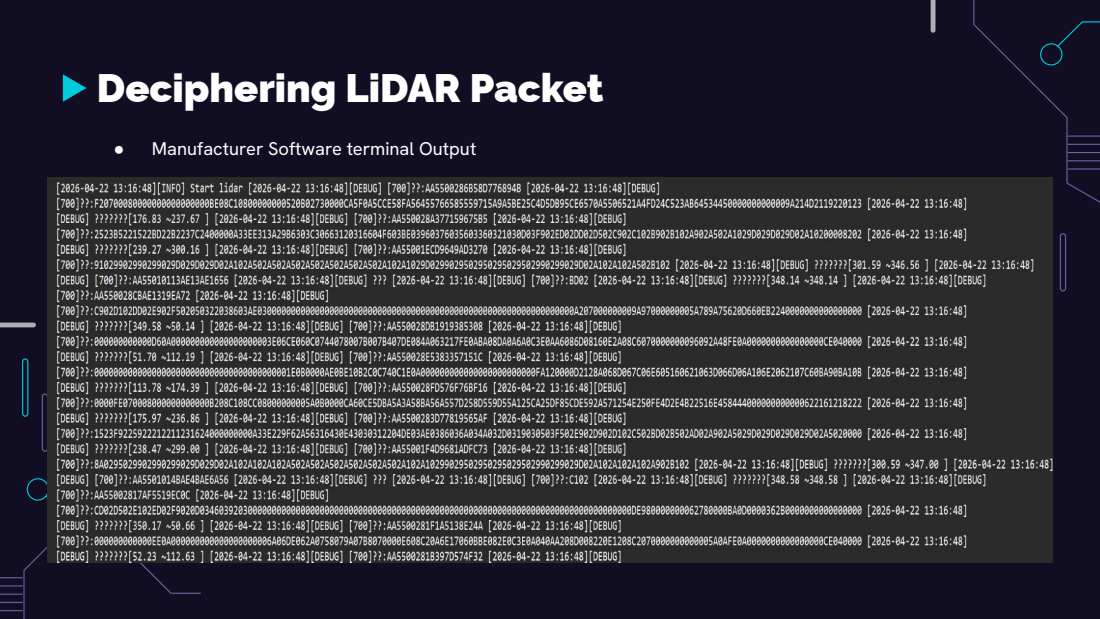
[picture p108: page 12]

● Manufacturer Software terminal Output

# Deciphering LiDAR Packet (cont.)

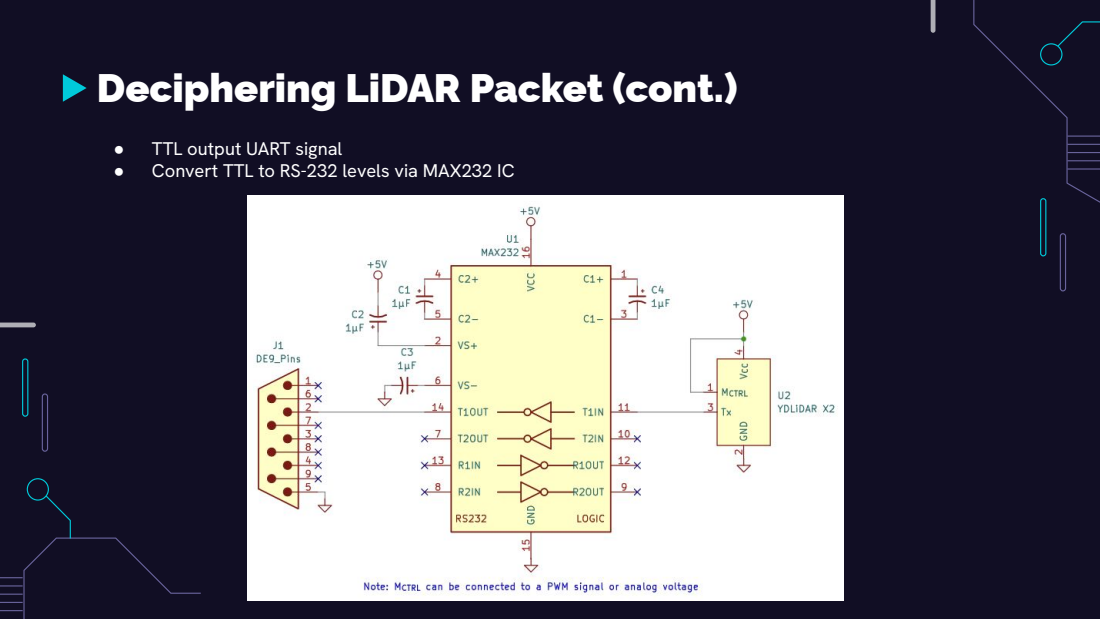
[picture p109: page 13]

● TTL output UART signal
● Convert TTL to RS-232 levels via MAX232 IC

# Deciphering LiDAR Packet (cont.)

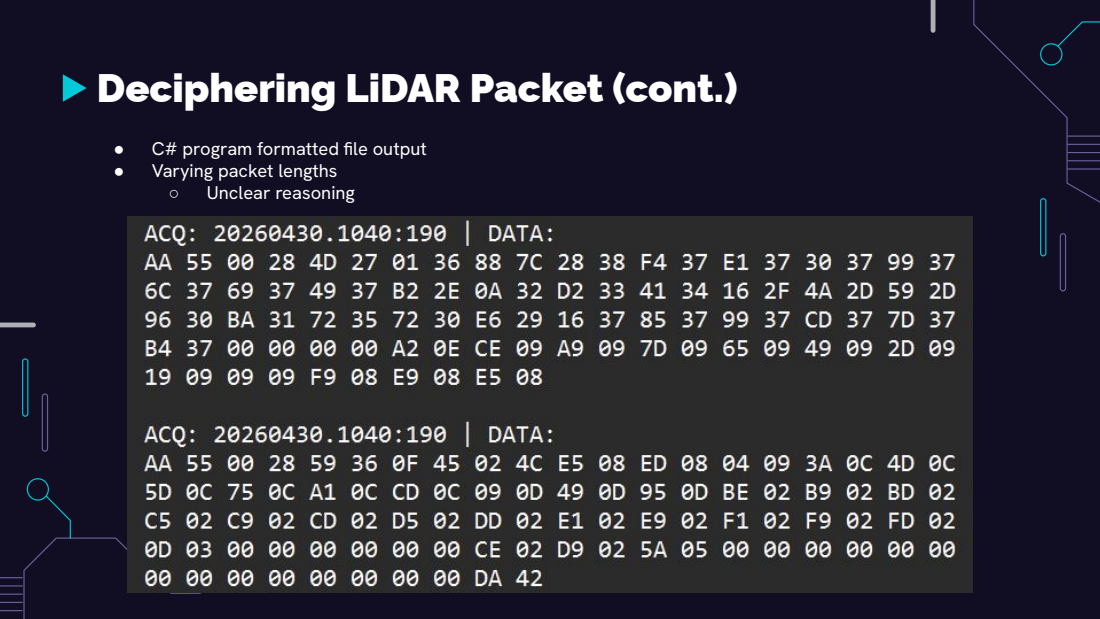
[picture p110: page 14]

● C# program formatted file output
● Varying packet lengths
○ Unclear reasoning

# Deciphering LiDAR Packet (cont.)

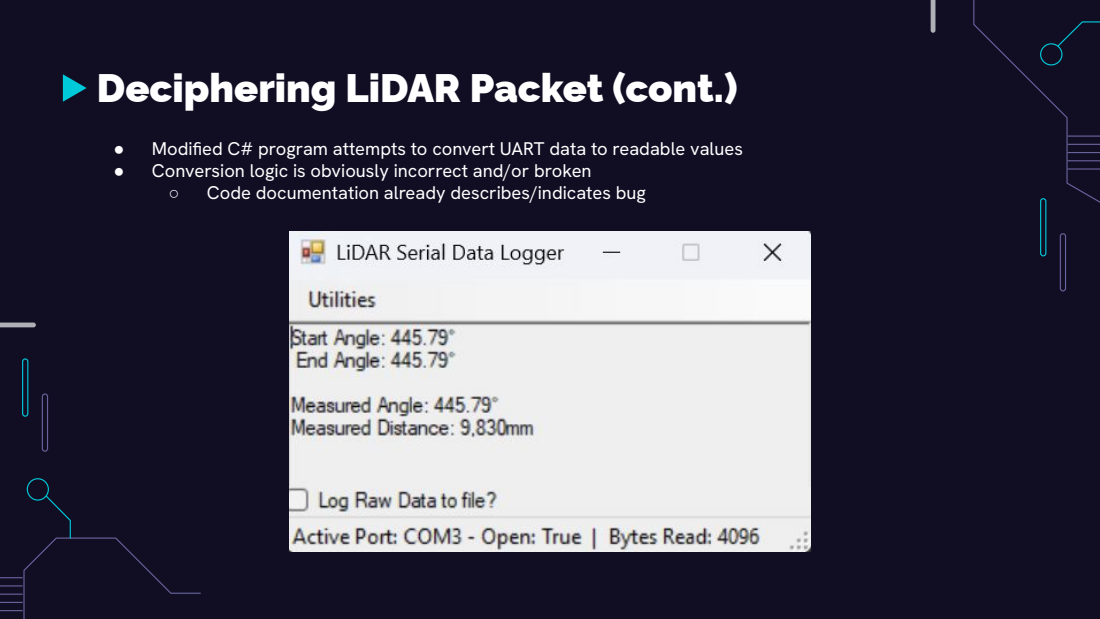
[picture p111: page 15]

● Modified C# program attempts to convert UART data to readable values
● Conversion logic is obviously incorrect and/or broken
○ Code documentation already describes/indicates bug

# Cost Analysis

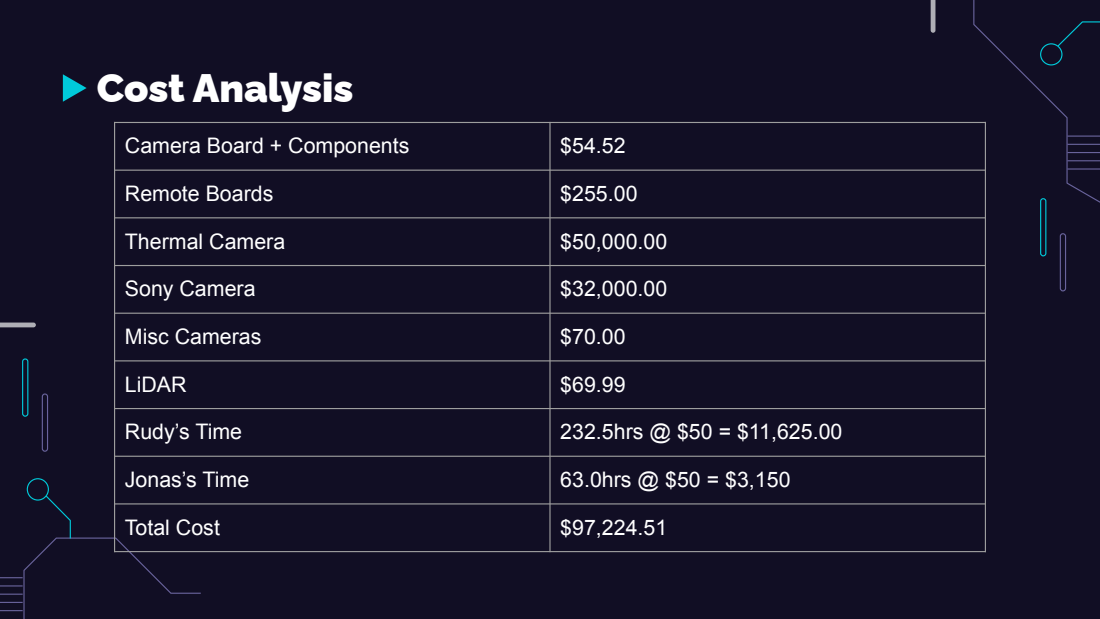
[picture p112: page 16]

Camera Board + Components | $54.52

Remote Boards | $255.00

Thermal Camera | $50,000.00

Sony Camera | $32,000.00

Misc Cameras | $70.00

LiDAR | $69.99

Rudy’s Time | 232.5hrs @ $50 = $11,625.00

Jonas’s Time | 63.0hrs @ $50 = $3,150

Total Cost | $97,224.51

# Conclusions and Recommendations

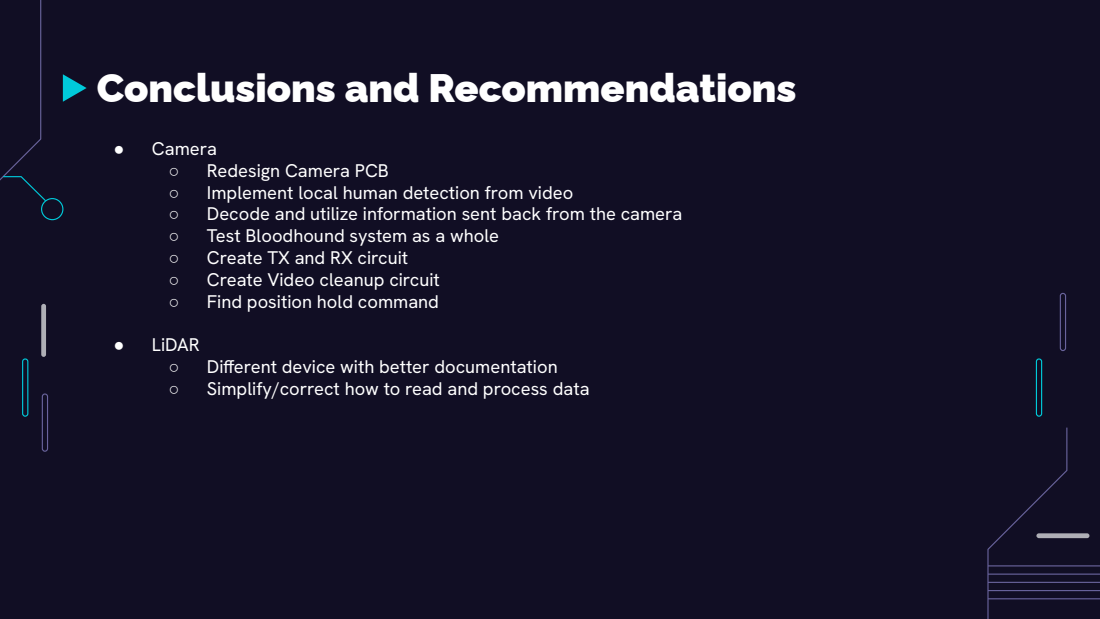
[picture p113: page 17]

● Camera
○ Redesign Camera PCB
○ Implement local human detection from video
○ Decode and utilize information sent back from the camera
○ Test Bloodhound system as a whole
○ Create TX and RX circuit
○ Create Video cleanup circuit
○ Find position hold command

● LiDAR
○ Different device with better documentation
○ Simplify/correct how to read and process data

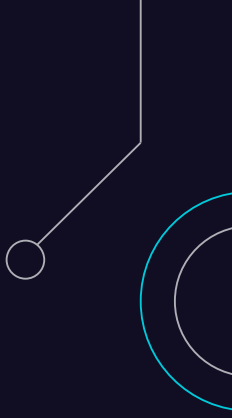
[picture p114: figure]

# Questions

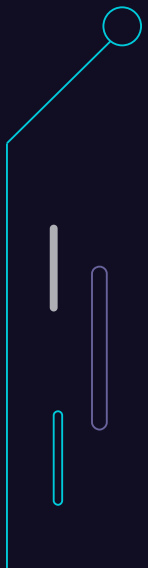
[picture p115: figure]

?

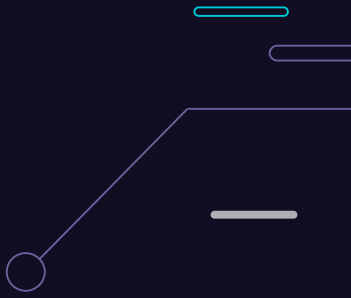
[picture p116: figure]
