rc-earnest/BloodHound/Documents/Development Board 2025 Schematic.pdf

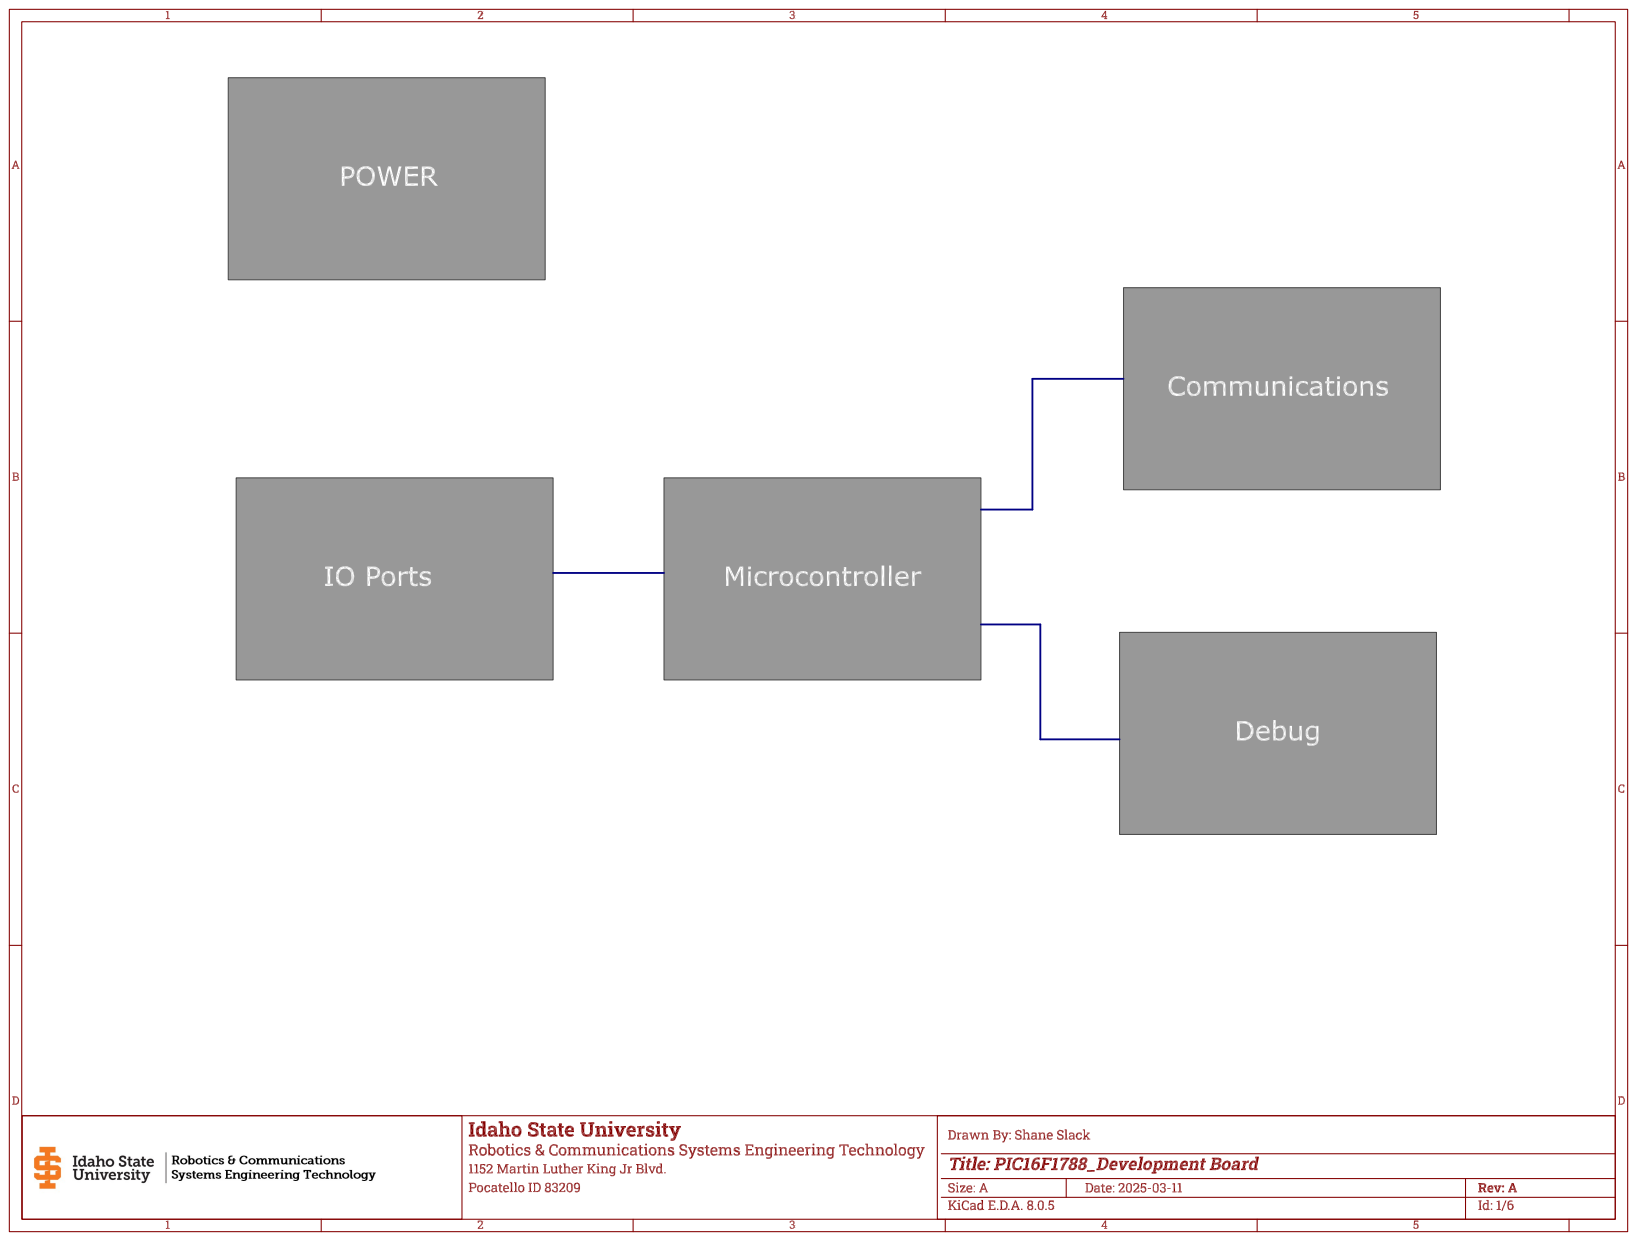
[picture p117: page 1]

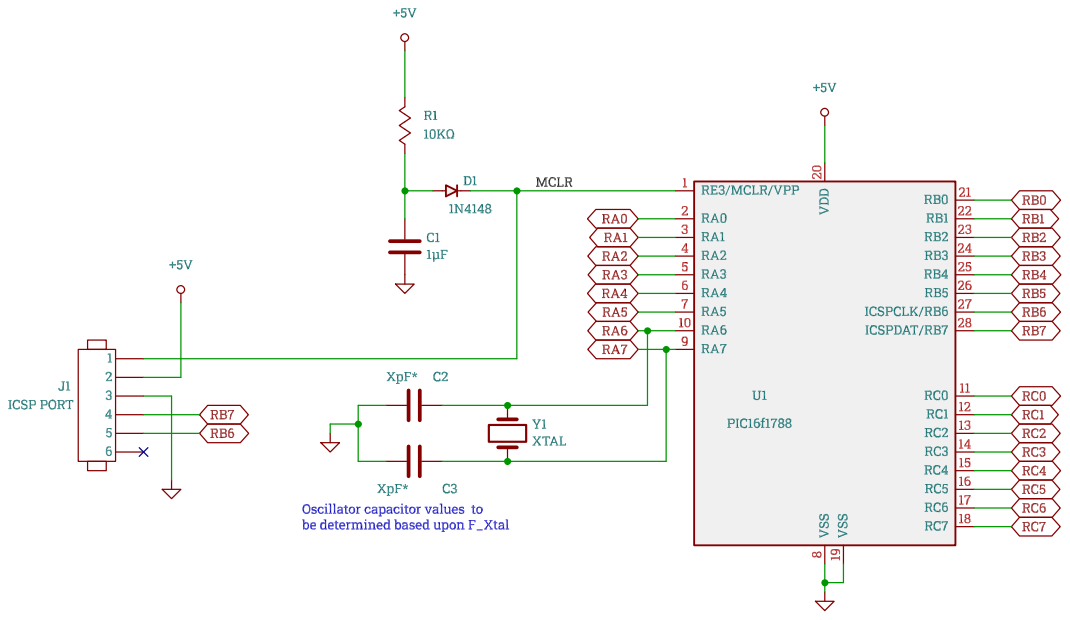
[picture p118: page 2]

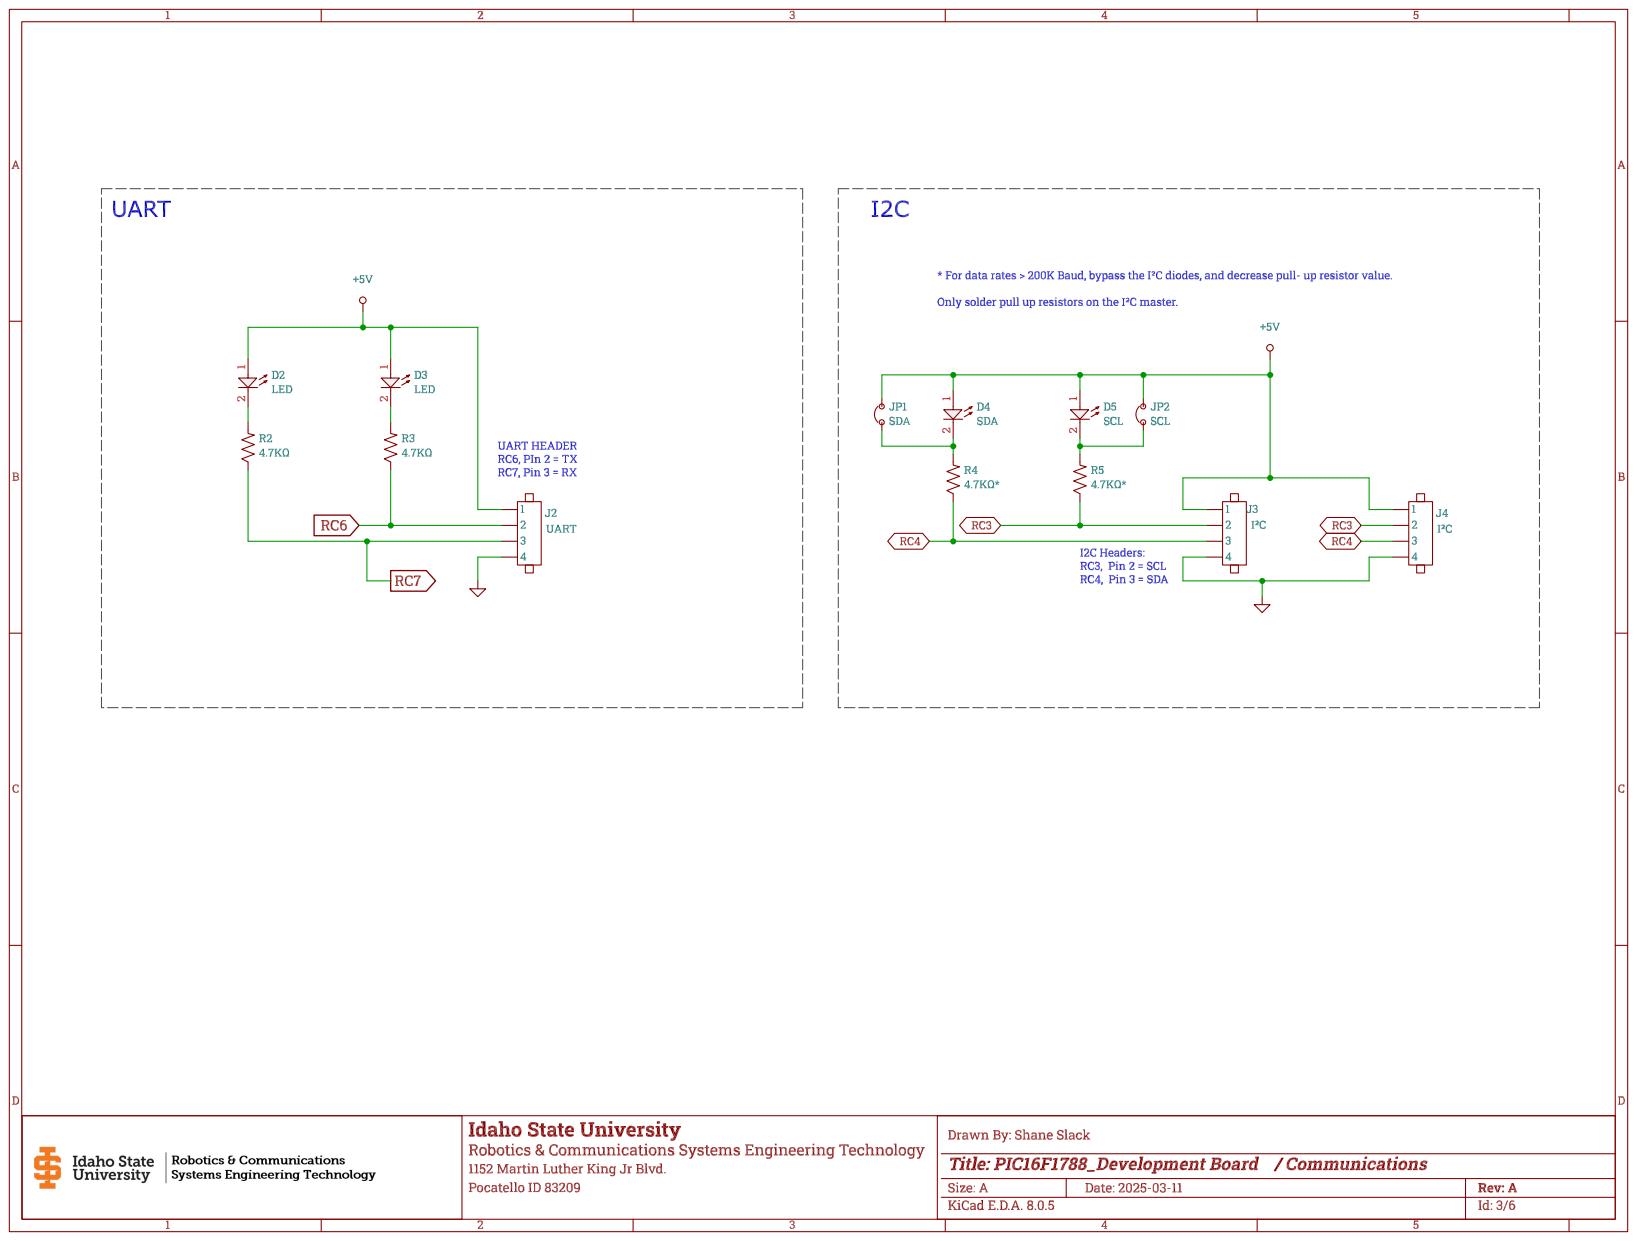
[picture p119: page 3]

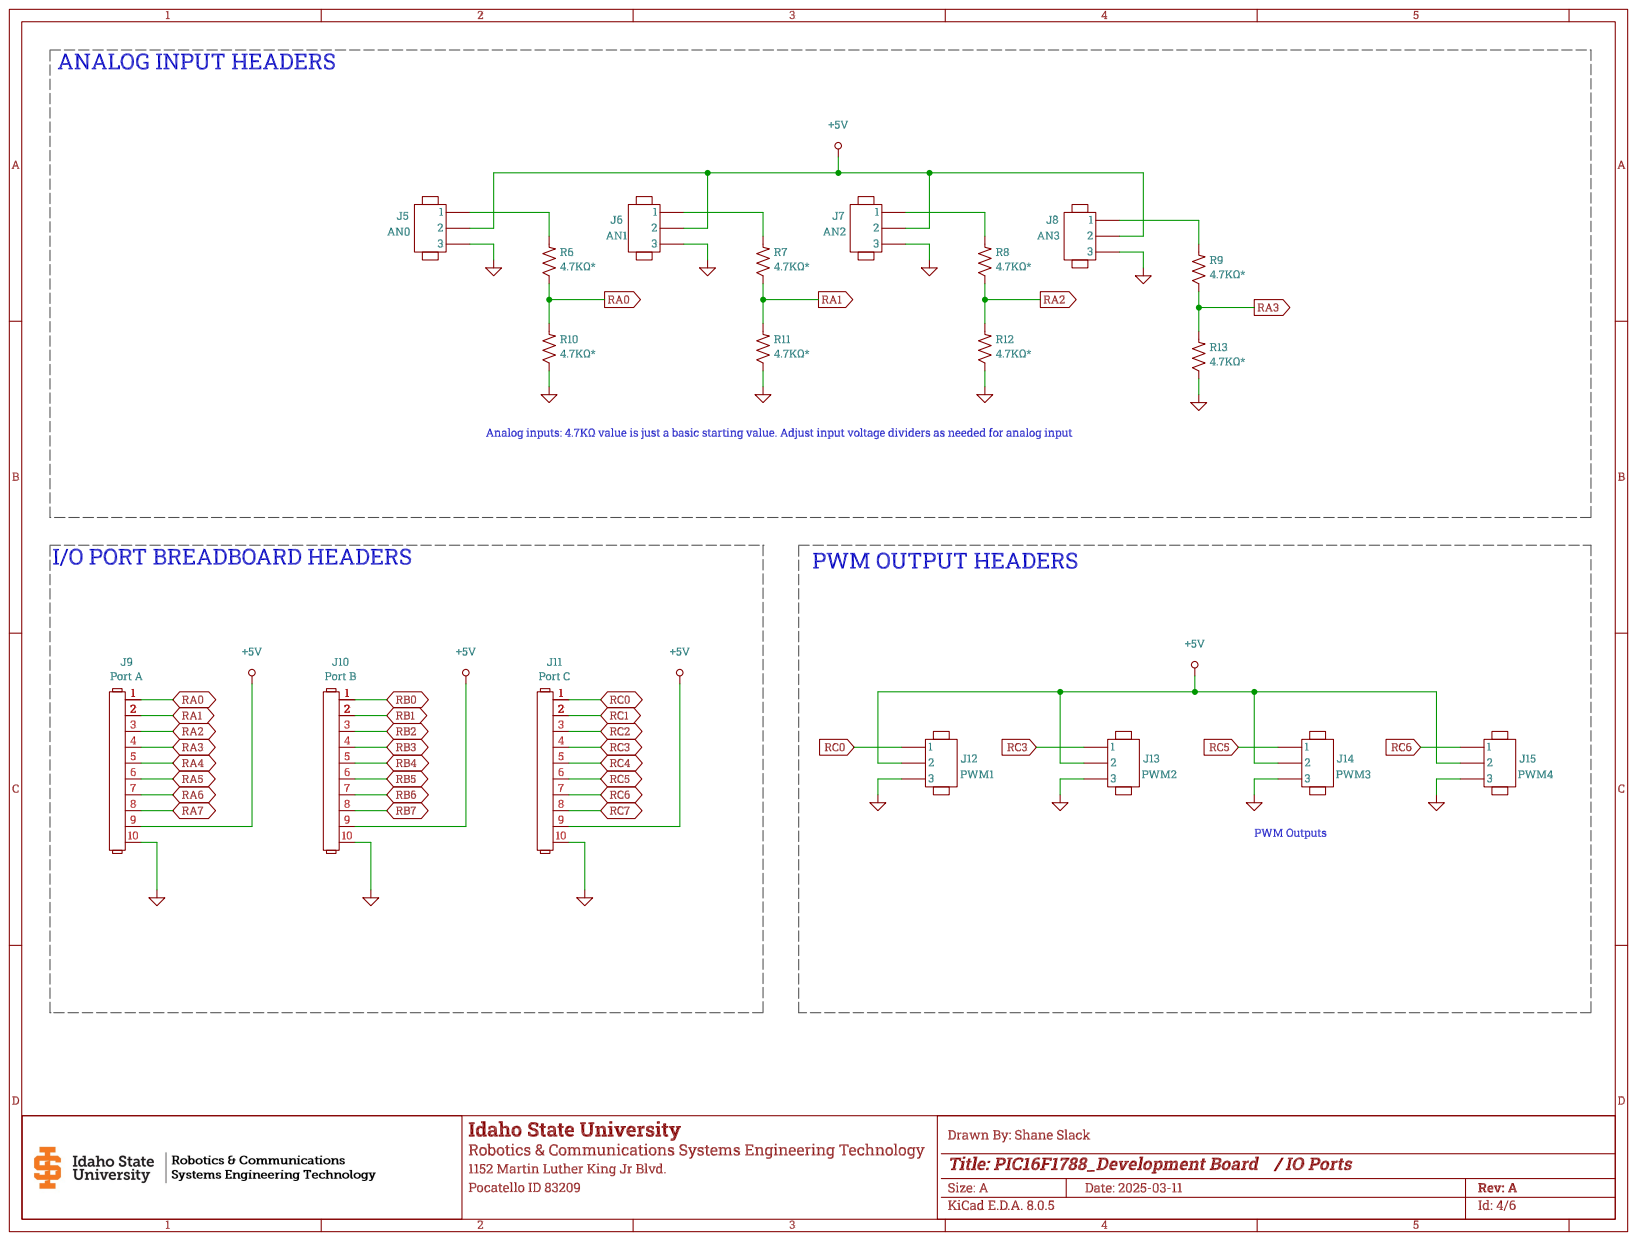
[picture p120: page 4]

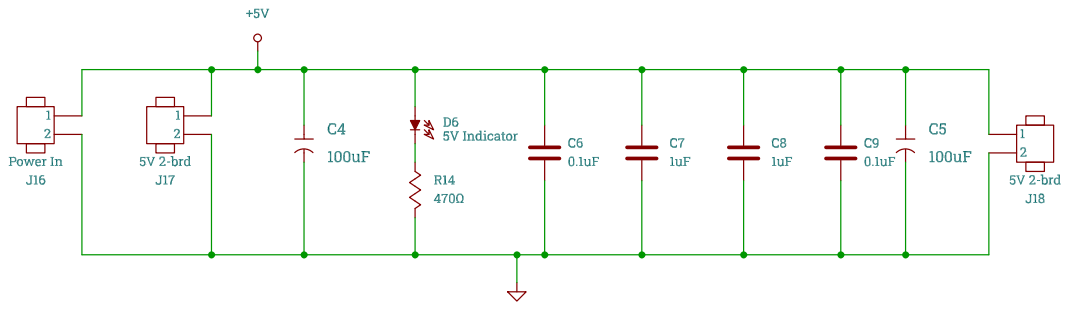
[picture p121: page 5]

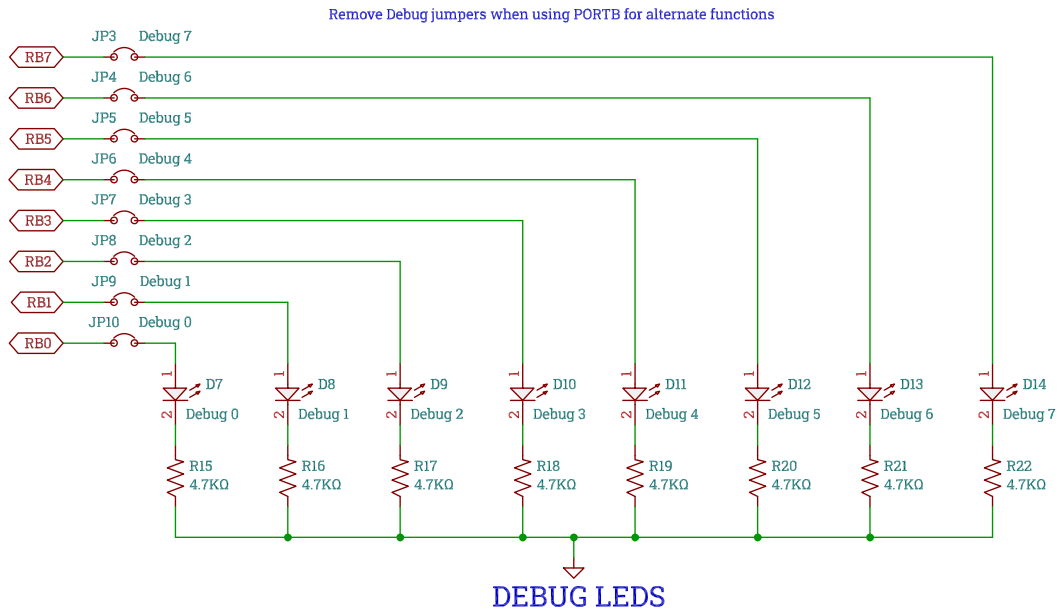
[picture p122: page 6]
