rc-earnest/BloodHound/Lidar/LiDAR Designed-Used Schematics - BW.pdf

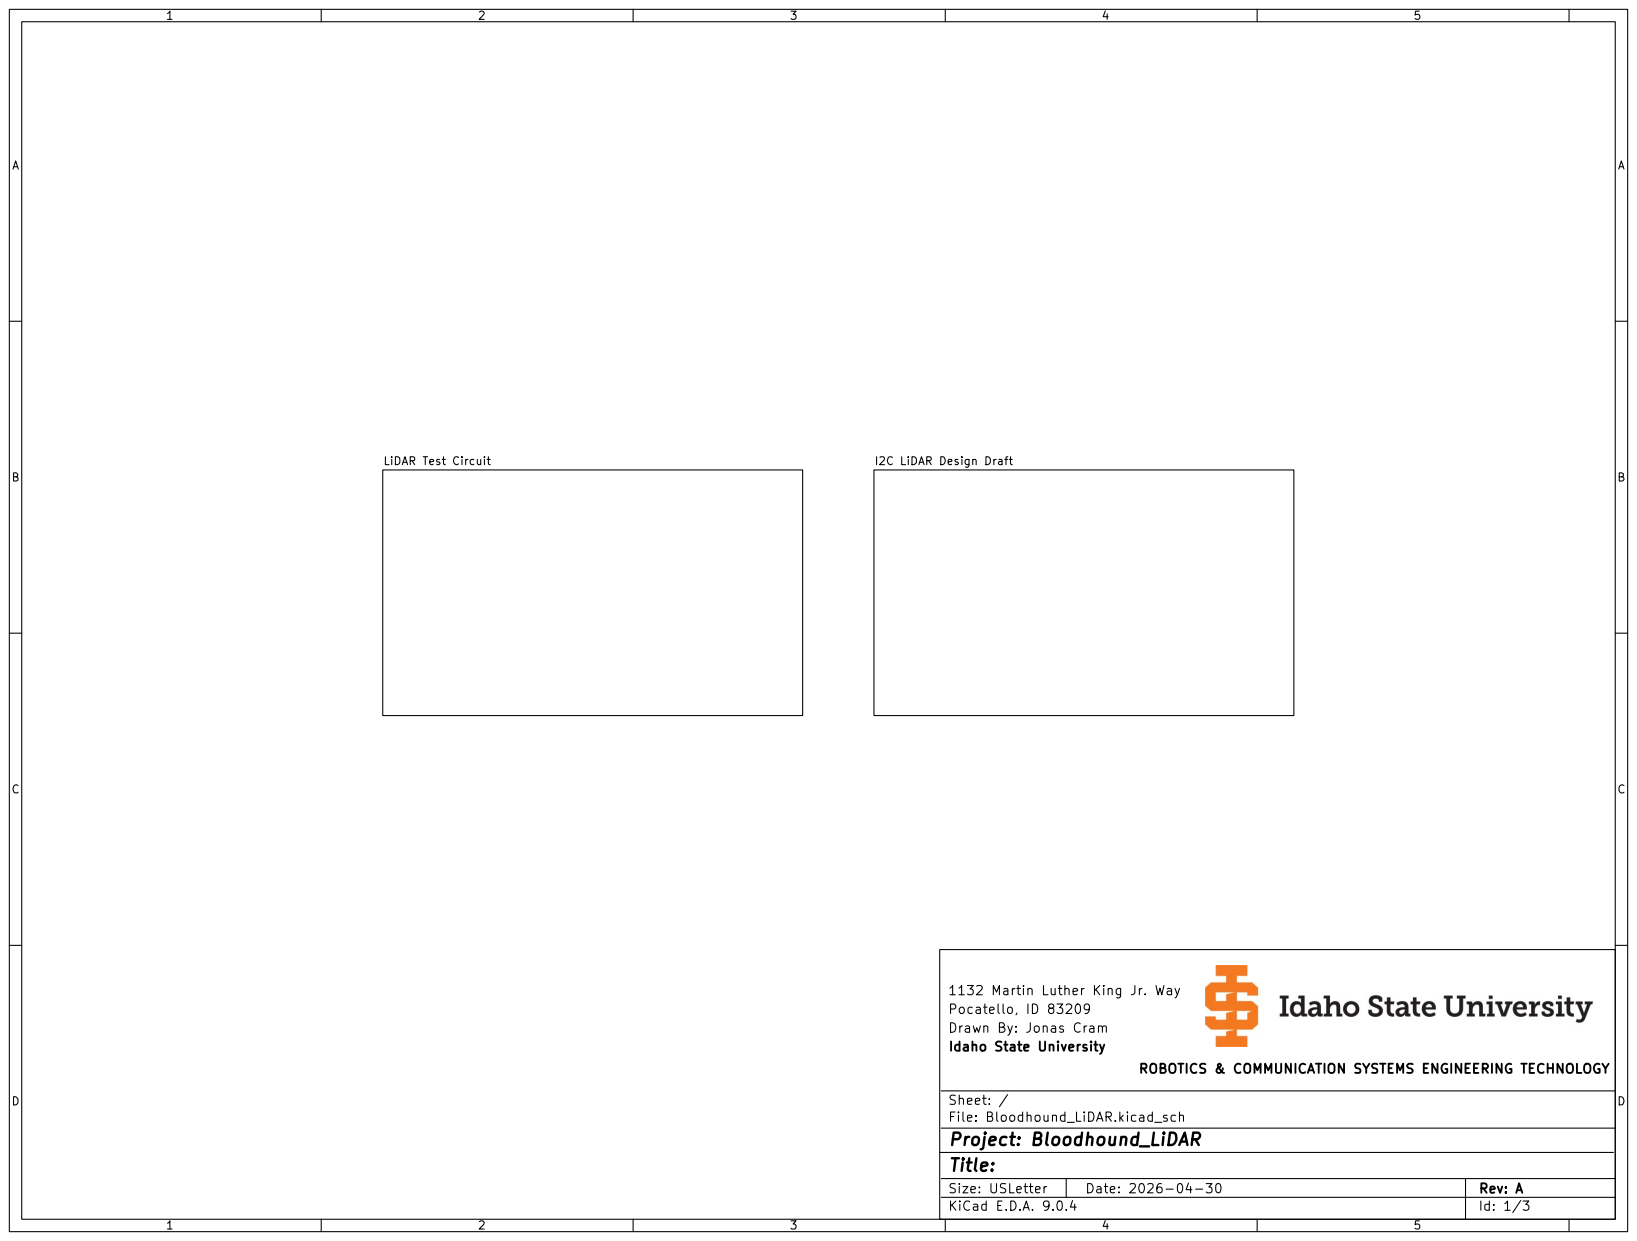
[picture p123: page 1]

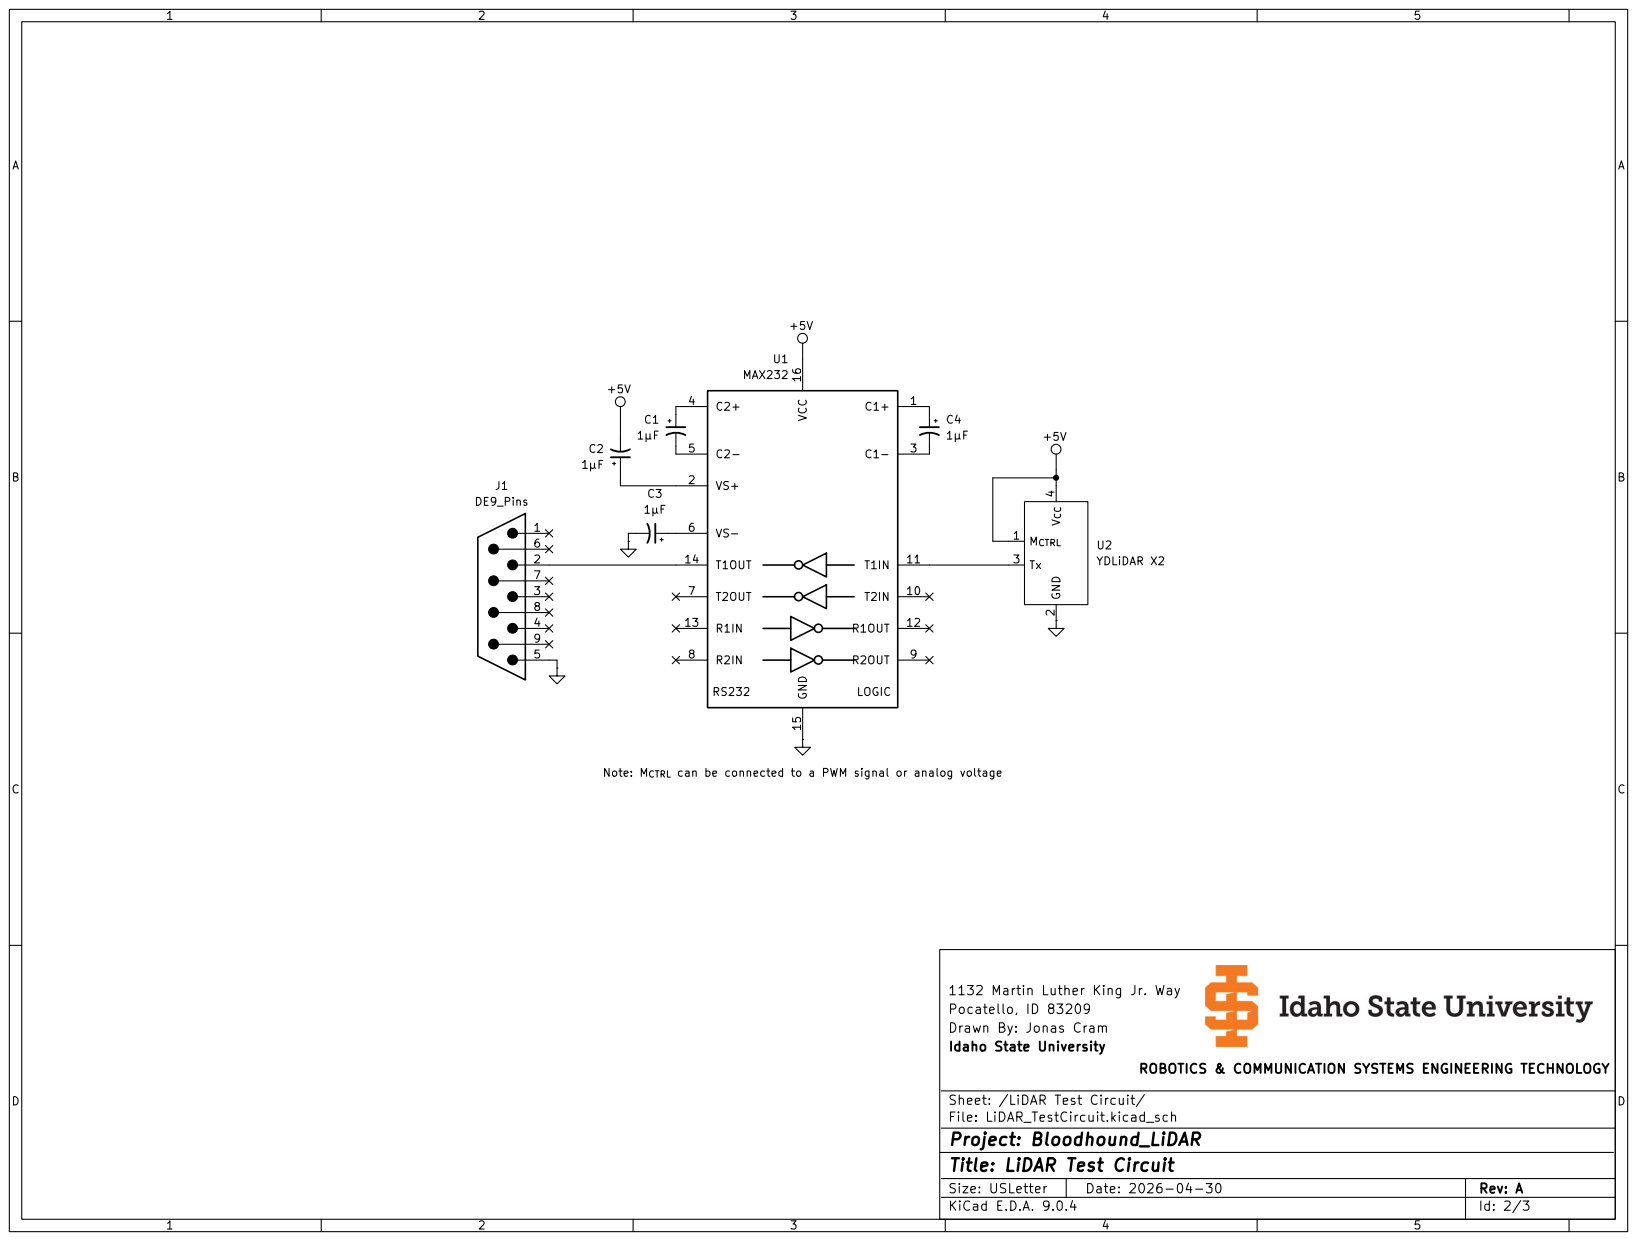
[picture p124: page 2]

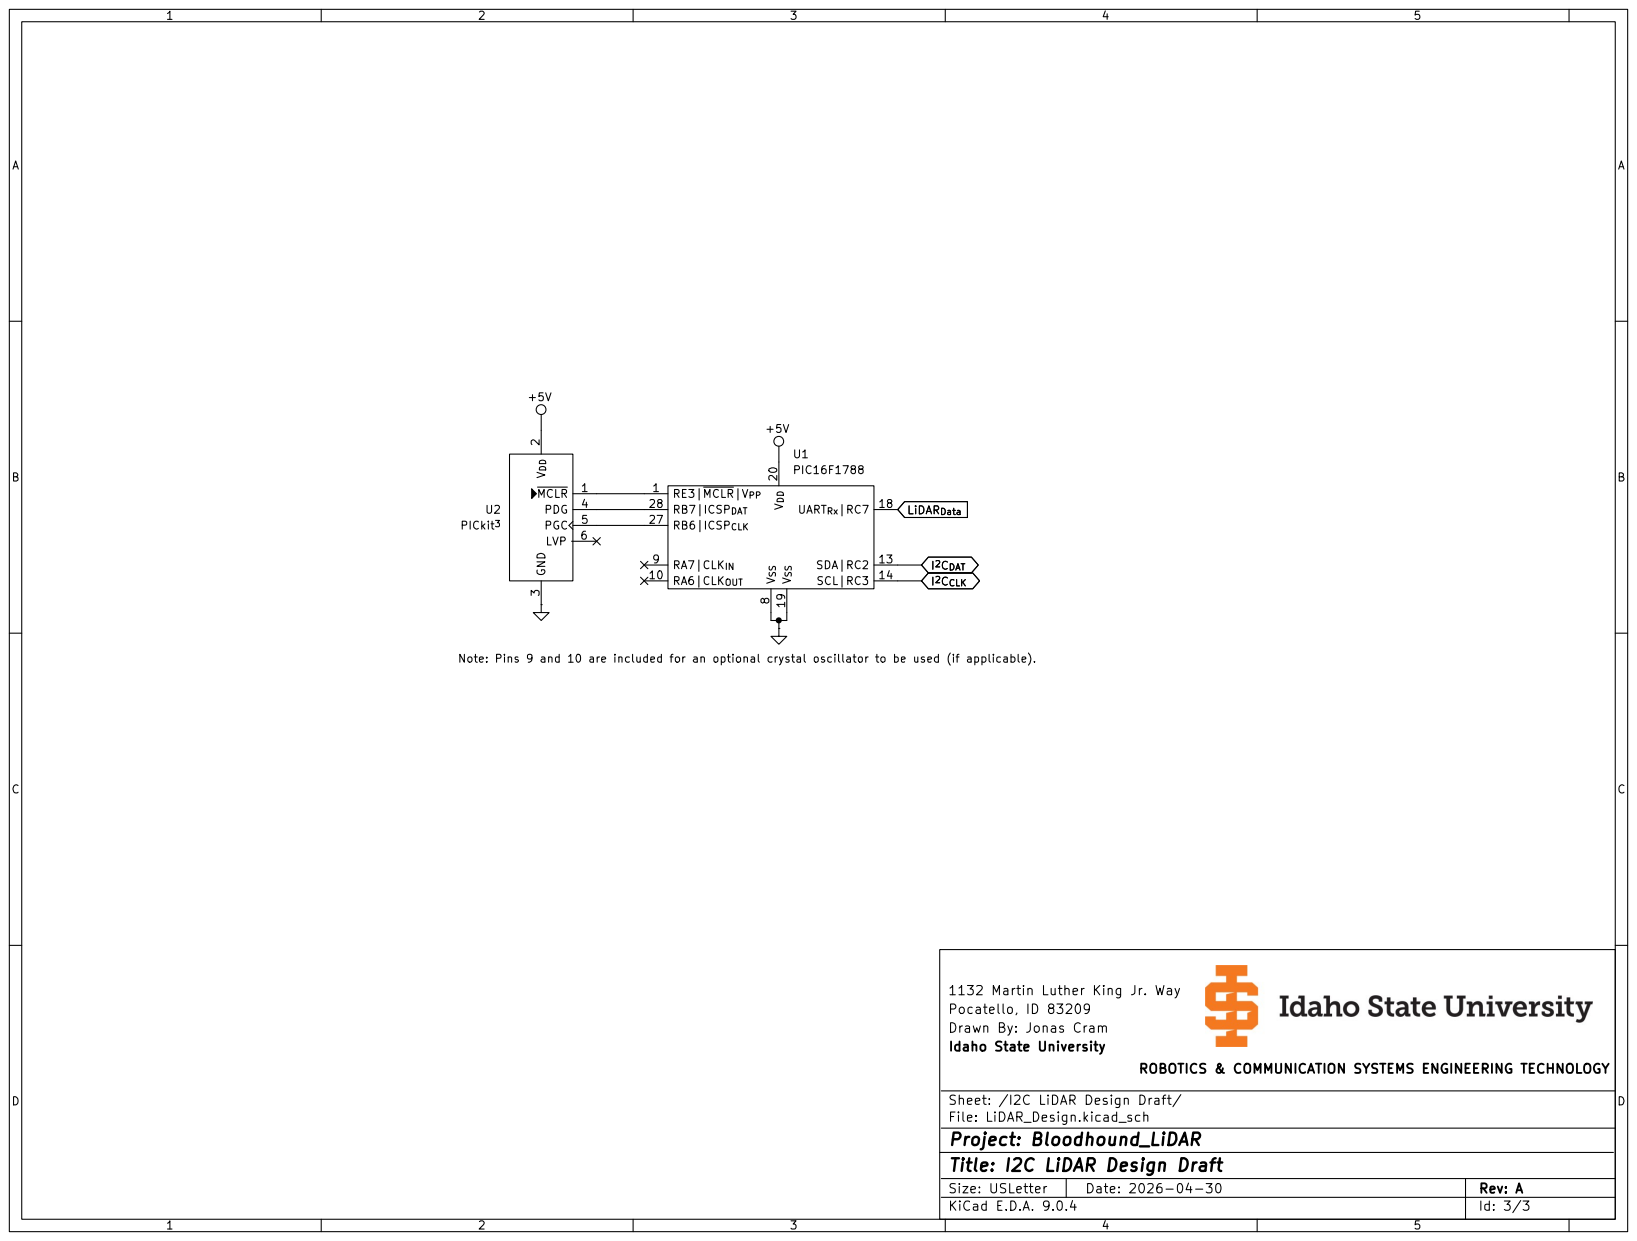
[picture p125: page 3]
