rc-earnest/BloodHound/Lidar/LiDAR Designed-Used Schematics.pdf

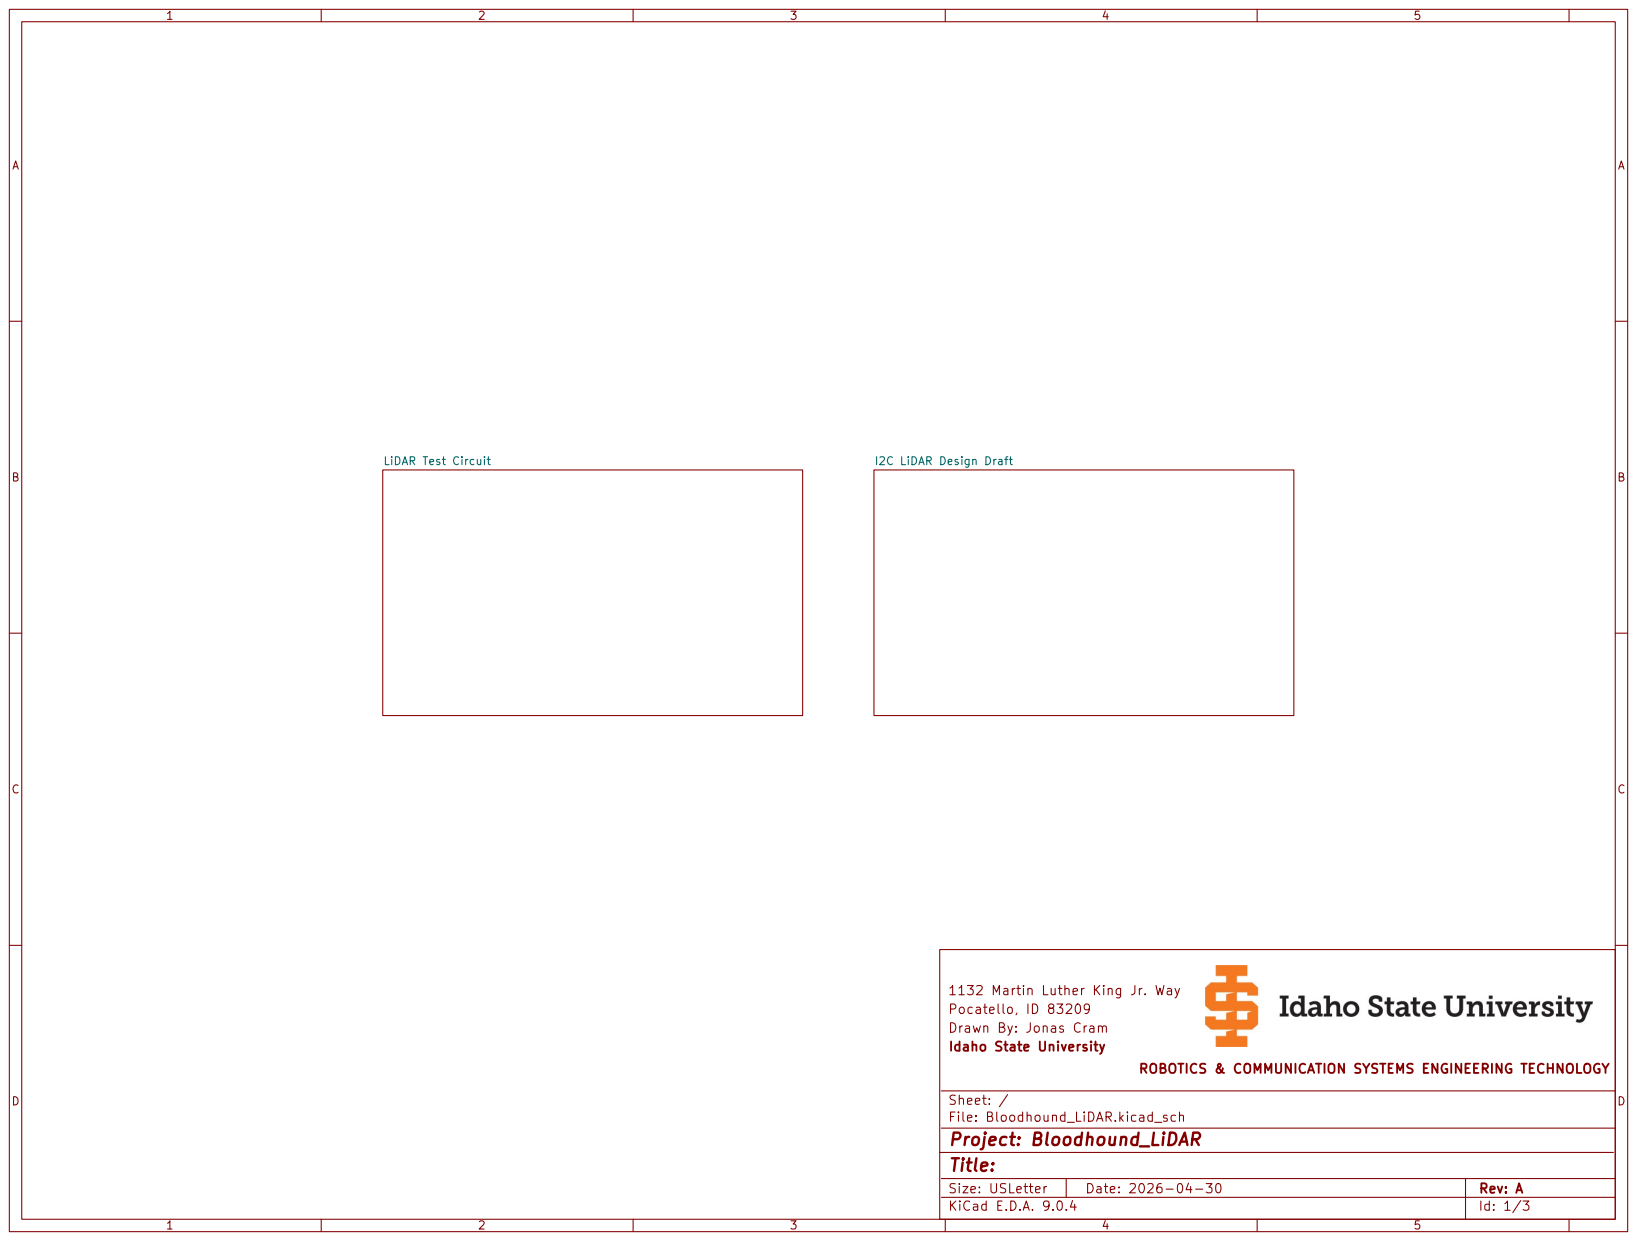
[picture p126: page 1]

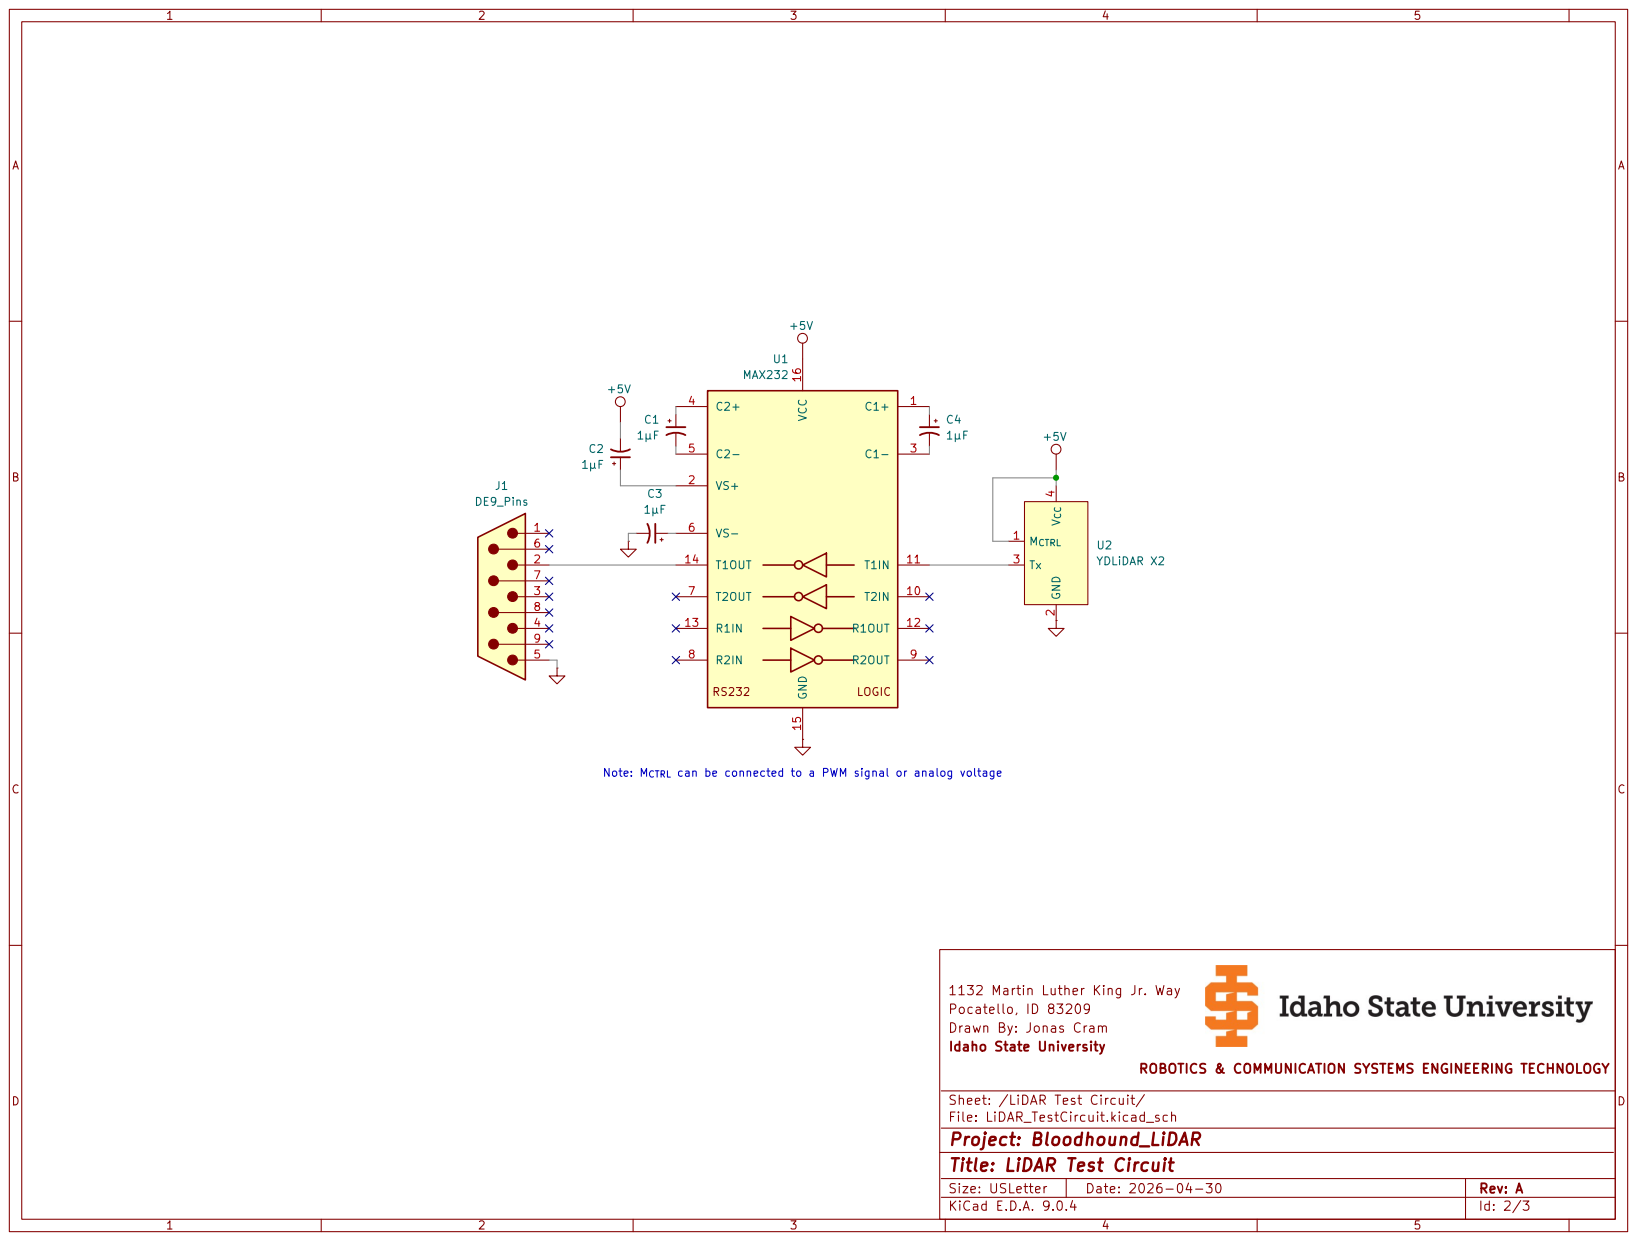
[picture p127: page 2]

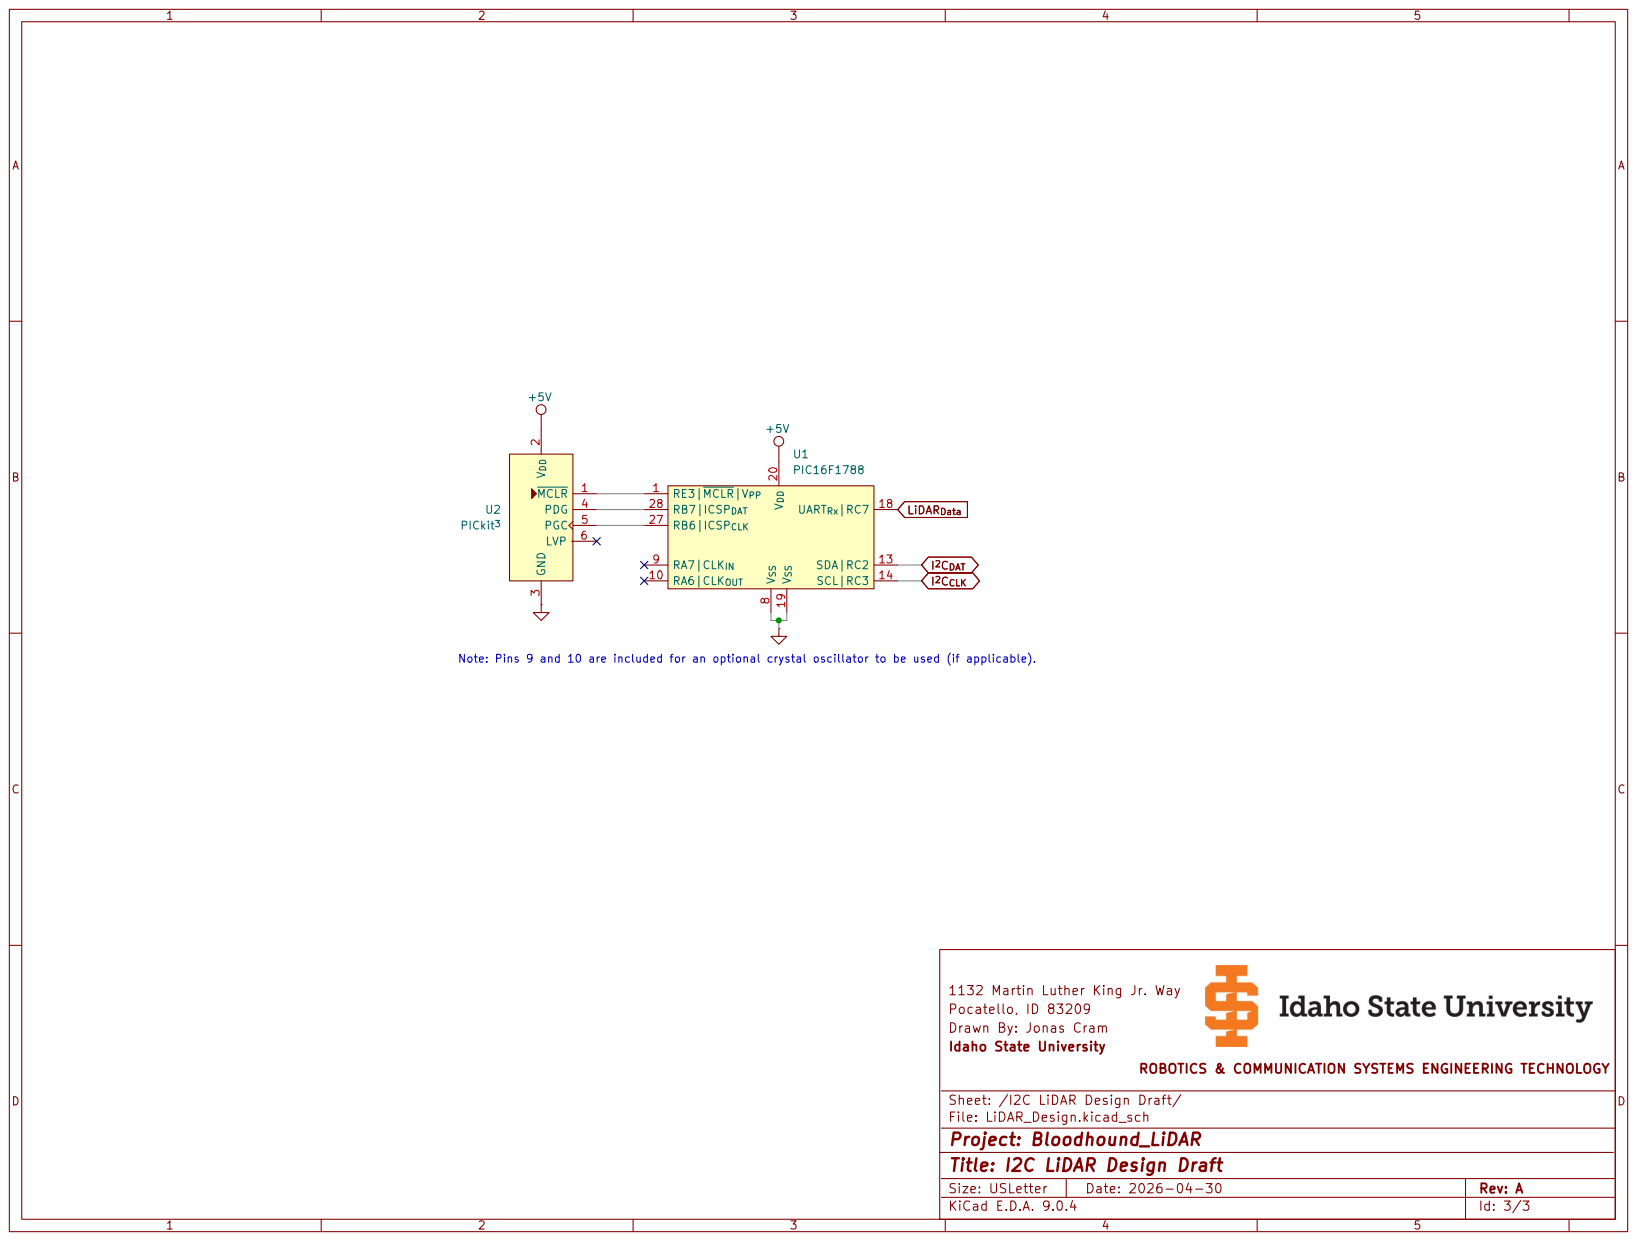
[picture p128: page 3]
