rc-earnest/BloodHound/GPS/Bloodhound GPS - BW.pdf

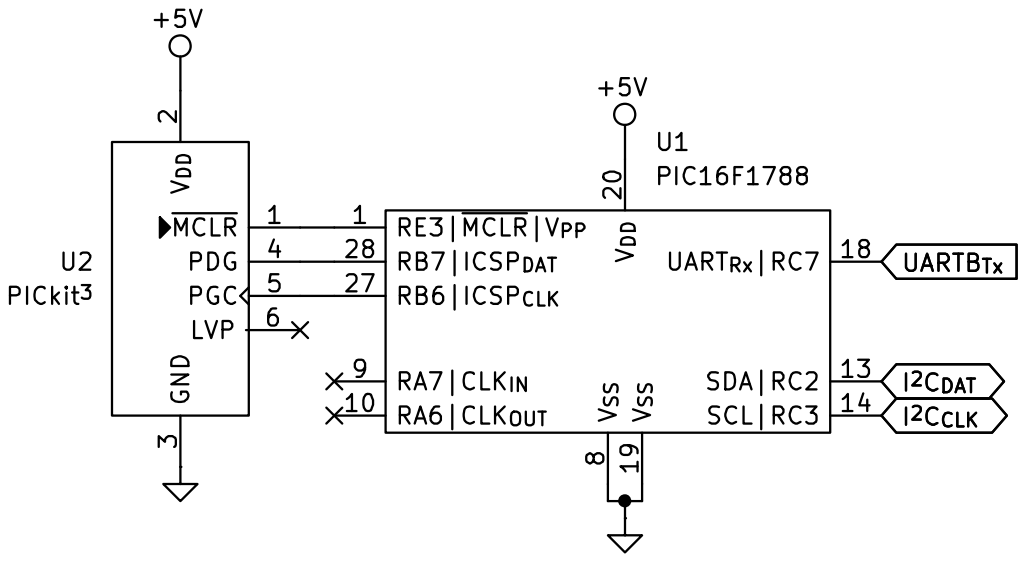
[picture p129: page 1]
