rc-earnest/BloodHound/GPS/Bloodhound GPS.pdf

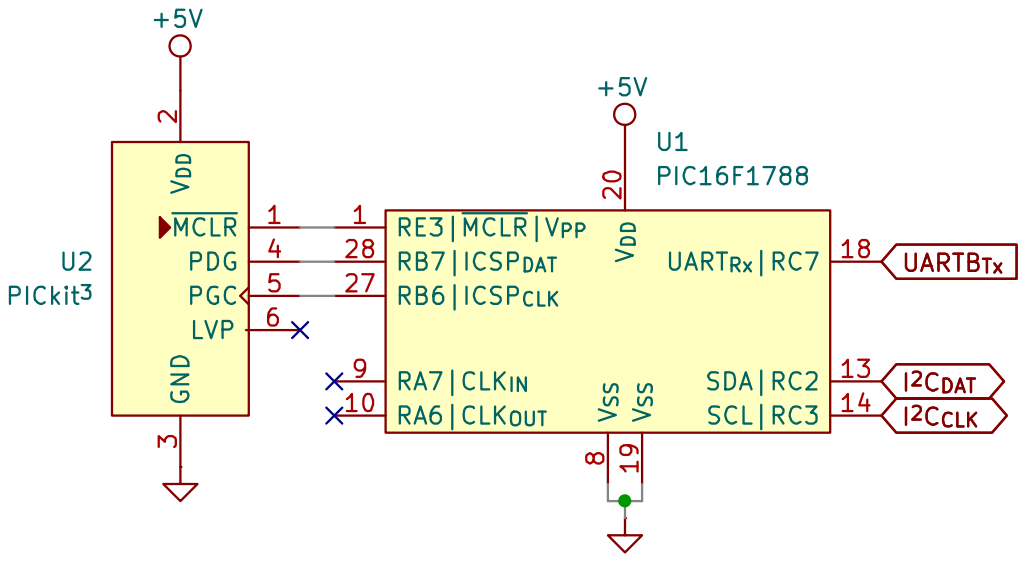
[picture p130: page 1]
