rc-earnest/BloodHound/Camera/CameraSlave_KiCad/ThermalCamera.kicad_pcb

## KiCad design Camera/CameraSlave_KiCad/ThermalCamera.kicad_pcb (2026-04-30)

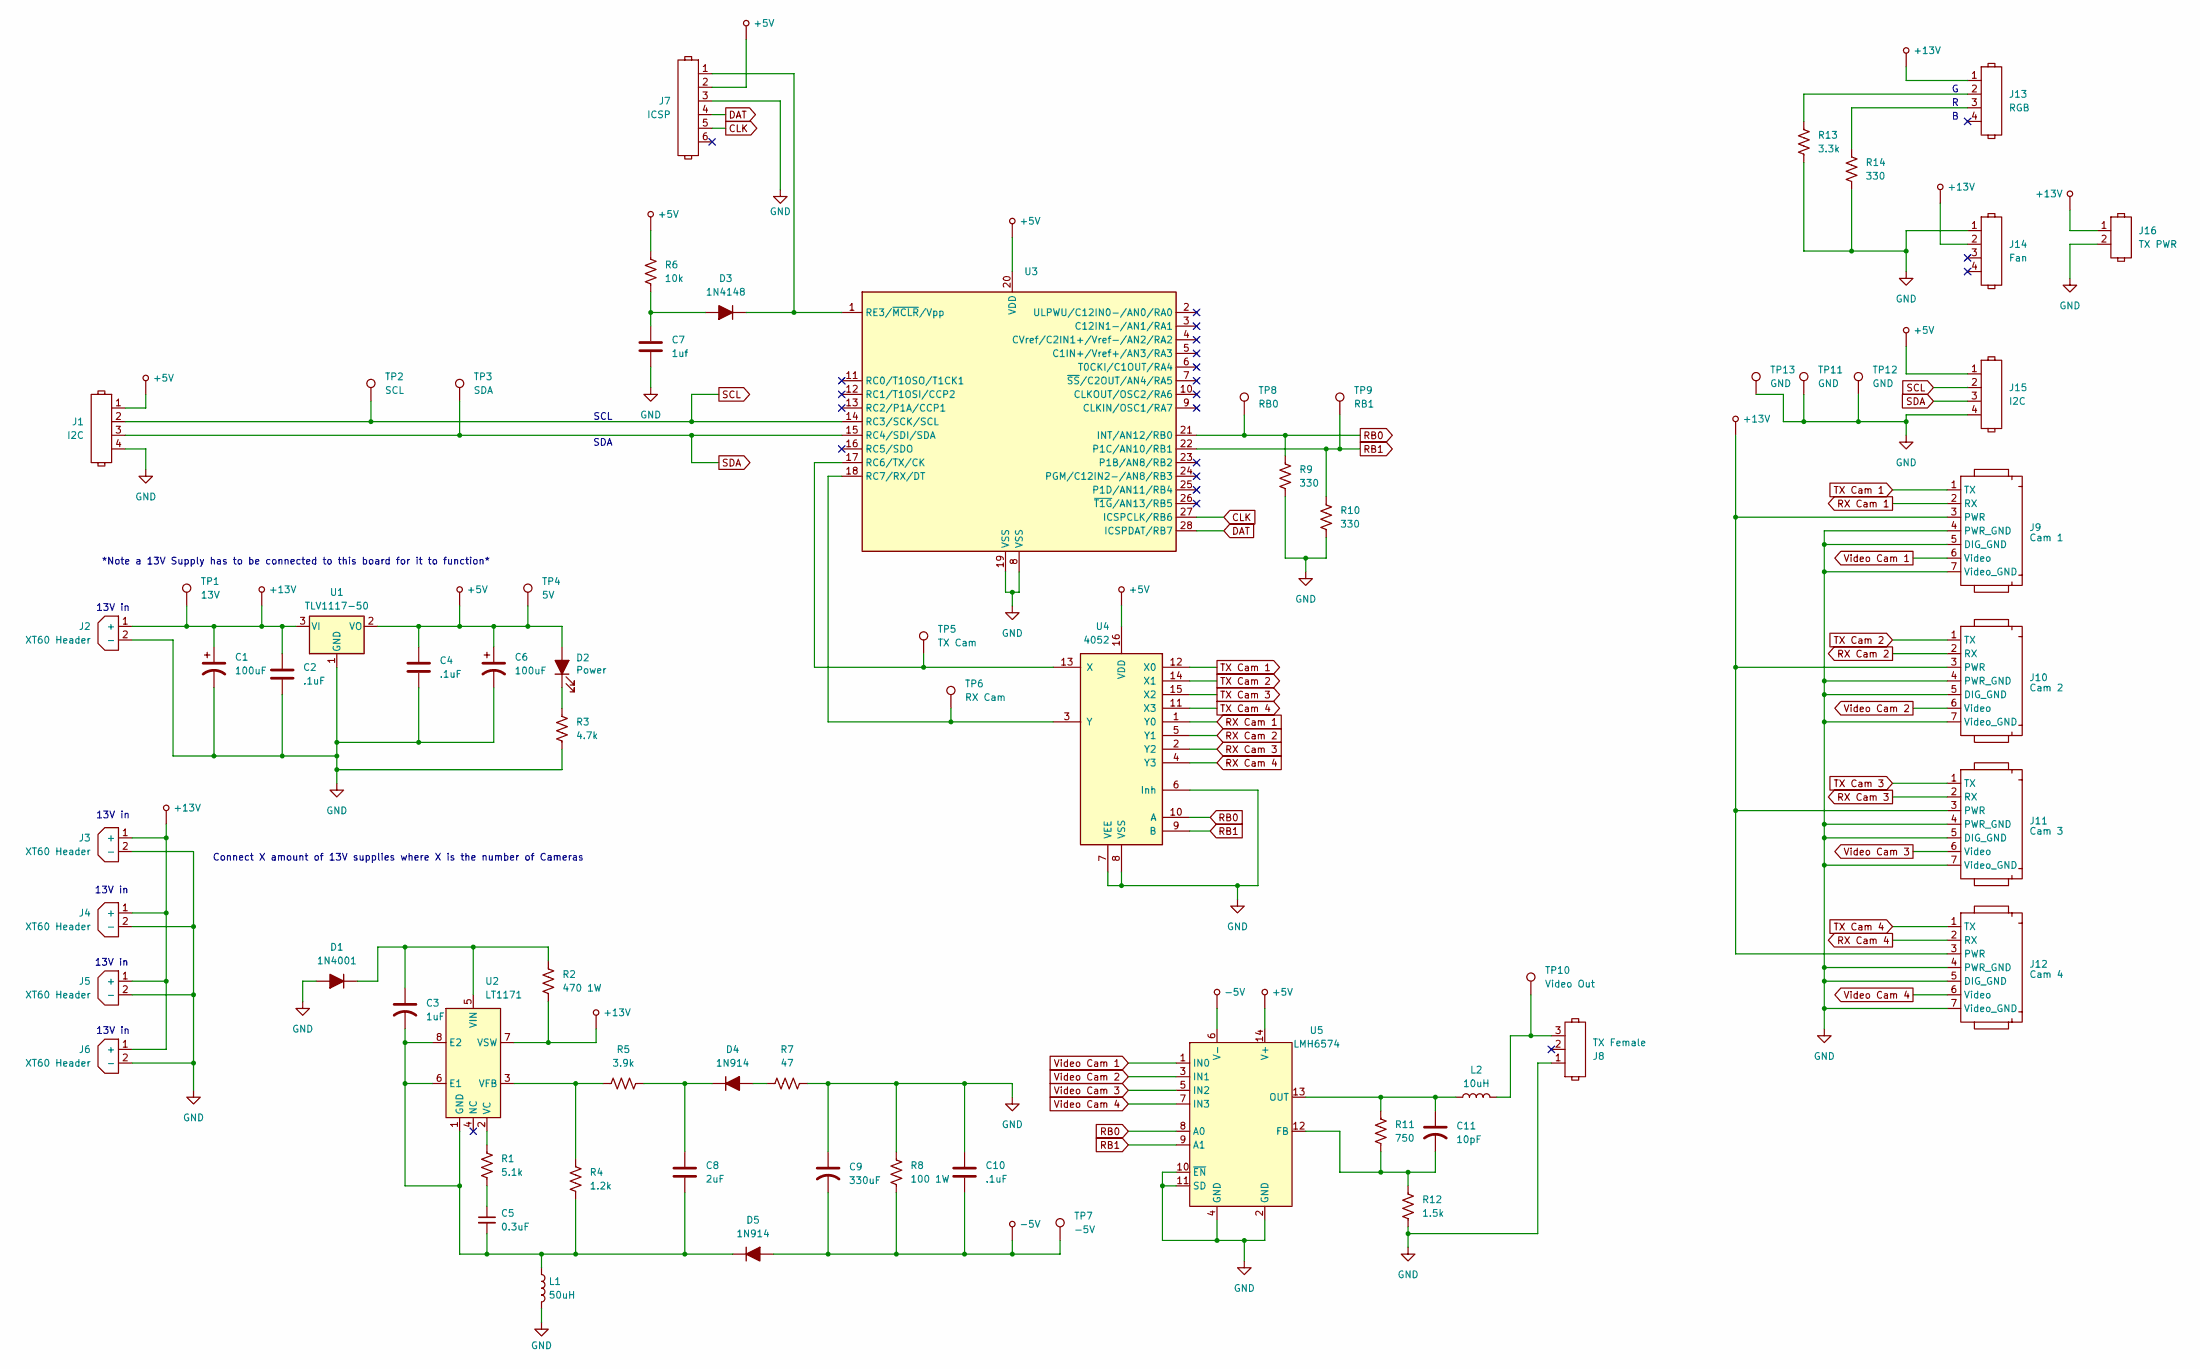
[picture p131: schematic ThermalCamera.kicad_sch, Camera Control Slave]

Parts:
C1, C6: 100uF; C_Radial_D5.0mm_H11.0mm_P2.00mm
C2, C4, C10: .1uF; 0805
C3: 1uF; 0805
C5: 0.3uF; 0805
C7: 1uf; 0805
C8: 2uF; 0805
C9: 330uF; C_Radial_D8.0mm_H11.5mm_P3.50mm
C11: 10pF; 0805
D1: 1N4001; DIODE_0805
D2: Power; DIODE_0805
D3: 1N4148; DIODE_0805
D4, D5: 1N914; DIODE_0805
J1, J15: I2C; Header_1_x_4
J2, J3, J4, J5, J6: XT60 Header; XT-60 Power Male (Load Side)
J7: ICSP; Header_1_x_6
J8: TX Female; Header_1_x_3
J9: Cam 1; Header_1_x_7
J10: Cam 2; Header_1_x_7
J11: Cam 3; Header_1_x_7
J12: Cam 4; Header_1_x_7
J13: RGB; Header_1_x_4
J14: Fan; Header_1_x_4
J16: TX PWR; Header_1_x_2
L1: 50uH; 78404064680
L2: 10uH; 0805
R1: 5.1k; 0805
R2: 470 1W; R_Axial_DIN0309_L9.0mm_D3.2mm_P12.70mm_Horizontal
R3: 4.7k; 0805
R4: 1.2k; 0805
R5: 3.9k; 0805
R6: 10k; 0805
R7: 47; 0805
R8: 100 1W; R_Axial_DIN0309_L9.0mm_D3.2mm_P12.70mm_Horizontal
R9, R10, R14: 330; 0805
R11: 750; 0805
R12: 1.5k; 0805
R13: 3.3k; 0805
TP1: 13V; Header_1_x_1
TP2: SCL; Header_1_x_1
TP3: SDA; Header_1_x_1
TP4: 5V; Header_1_x_1
TP5: TX Cam; Header_1_x_1
TP6: RX Cam; Header_1_x_1
TP7: -5V; Header_1_x_1
TP8: RB0; Header_1_x_1
TP9: RB1; Header_1_x_1
TP10: Video Out; Header_1_x_1
TP11, TP12, TP13: GND; Header_1_x_1
U1: TLV1117-50
U2: LT1171; LT1172
U3: PIC16F883
U4: 4052; CD4052BPWR
U5: LMH6574

Connections:
+5V: C4.1, C6.1, D2.2 (A), J1.1, J7.2, J15.1, R6.1, TP4.1, U1.2 (VO), U3.20 (VDD), U4.16 (VDD), U5.14 (V+)
+13V: C1.1, C2.1, J2.1 (+), J3.1 (+), J4.1 (+), J5.1 (+), J6.1 (+), J9.3 (PWR), J10.3 (PWR), J11.3 (PWR), J12.3 (PWR), J13.1, J14.2, J16.1, R2.2, TP1.1, U1.3 (VI), U2.7 (VSW)
-5V: C9.2, C10.2, D5.2 (A), R8.2, TP7.1, U5.6 (V-)
CLK: J7.5, U3.27 (ICSPCLK/RB6)
DAT: J7.4, U3.28 (ICSPDAT/RB7)
GND: C1.2, C2.2, C4.2, C6.2, C7.2, C9.1, C10.1, D1.2 (A), J1.4, J2.2 (-), J3.2 (-), J4.2 (-), J5.2 (-), J6.2 (-), J7.3, J8.1, J9.4 (PWR_GND), J9.5 (DIG_GND), J9.7 (Video_GND), J10.4 (PWR_GND), J10.5 (DIG_GND), J10.7 (Video_GND), J11.4 (PWR_GND), J11.5 (DIG_GND), J11.7 (Video_GND), J12.4 (PWR_GND), J12.5 (DIG_GND), J12.7 (Video_GND), J14.1, J15.4, J16.2, L1.2, R3.2, R7.2, R8.1, R9.2, R10.2, R12.2, R13.2, R14.2, TP11.1, TP12.1, TP13.1, U1.1 (GND), U3.8 (VSS), U3.19 (VSS), U4.6 (Inh), U4.7 (VEE), U4.8 (VSS), U5.2 (GND), U5.4 (GND), U5.10 (~EN), U5.11 (SD)
unnamed: C5.1, R1.2
unnamed: C3.1, D1.1 (K), R2.1, U2.5 (VIN)
unnamed: D2.1 (K), R3.1
unnamed: C7.1, D3.2 (A), R6.2
unnamed: D3.1 (K), J7.1, U3.1 (RE3/~MCLR/Vpp)
unnamed: D4.2 (A), R7.1
unnamed: C8.1, D4.1 (K), R5.2
unnamed: C3.2, C5.2, C8.2, D5.1 (K), L1.1, R4.2, U2.1 (GND), U2.6 (E1), U2.8 (E2)
unnamed: J8.3, L2.2, TP10.1
unnamed: J13.2, R13.1
unnamed: J13.3, R14.1
unnamed: R1.1, U2.2 (VC)
unnamed: R4.1, R5.1, U2.3 (VFB)
unnamed: TP5.1, U3.17 (RC6/TX/CK), U4.13 (X)
unnamed: TP6.1, U3.18 (RC7/RX/DT), U4.3 (Y)
unnamed: C11.2, R11.2, R12.1, U5.12 (FB)
unnamed: C11.1, L2.1, R11.1, U5.13 (OUT)
RB0: R9.1, TP8.1, U3.21 (INT/AN12/RB0), U4.10 (A), U5.8 (A0)
RB1: R10.1, TP9.1, U3.22 (P1C/AN10/RB1), U4.9 (B), U5.9 (A1)
RX Cam 1: J9.2 (RX), U4.1 (Y0)
RX Cam 2: J10.2 (RX), U4.5 (Y1)
RX Cam 3: J11.2 (RX), U4.2 (Y2)
RX Cam 4: J12.2 (RX), U4.4 (Y3)
SCL: J1.2, J15.2, TP2.1, U3.14 (RC3/SCK/SCL)
SDA: J1.3, J15.3, TP3.1, U3.15 (RC4/SDI/SDA)
TX Cam 1: J9.1 (TX), U4.12 (X0)
TX Cam 2: J10.1 (TX), U4.14 (X1)
TX Cam 3: J11.1 (TX), U4.15 (X2)
TX Cam 4: J12.1 (TX), U4.11 (X3)
Video Cam 1: J9.6 (Video), U5.1 (IN0)
Video Cam 2: J10.6 (Video), U5.3 (IN1)
Video Cam 3: J11.6 (Video), U5.5 (IN2)
Video Cam 4: J12.6 (Video), U5.7 (IN3)

Notes on the sheet:
13V in
Connect X amount of 13V supplies where X is the number of Cameras
SDA
SCL
*Note a 13V Supply has to be connected to this board for it to function*

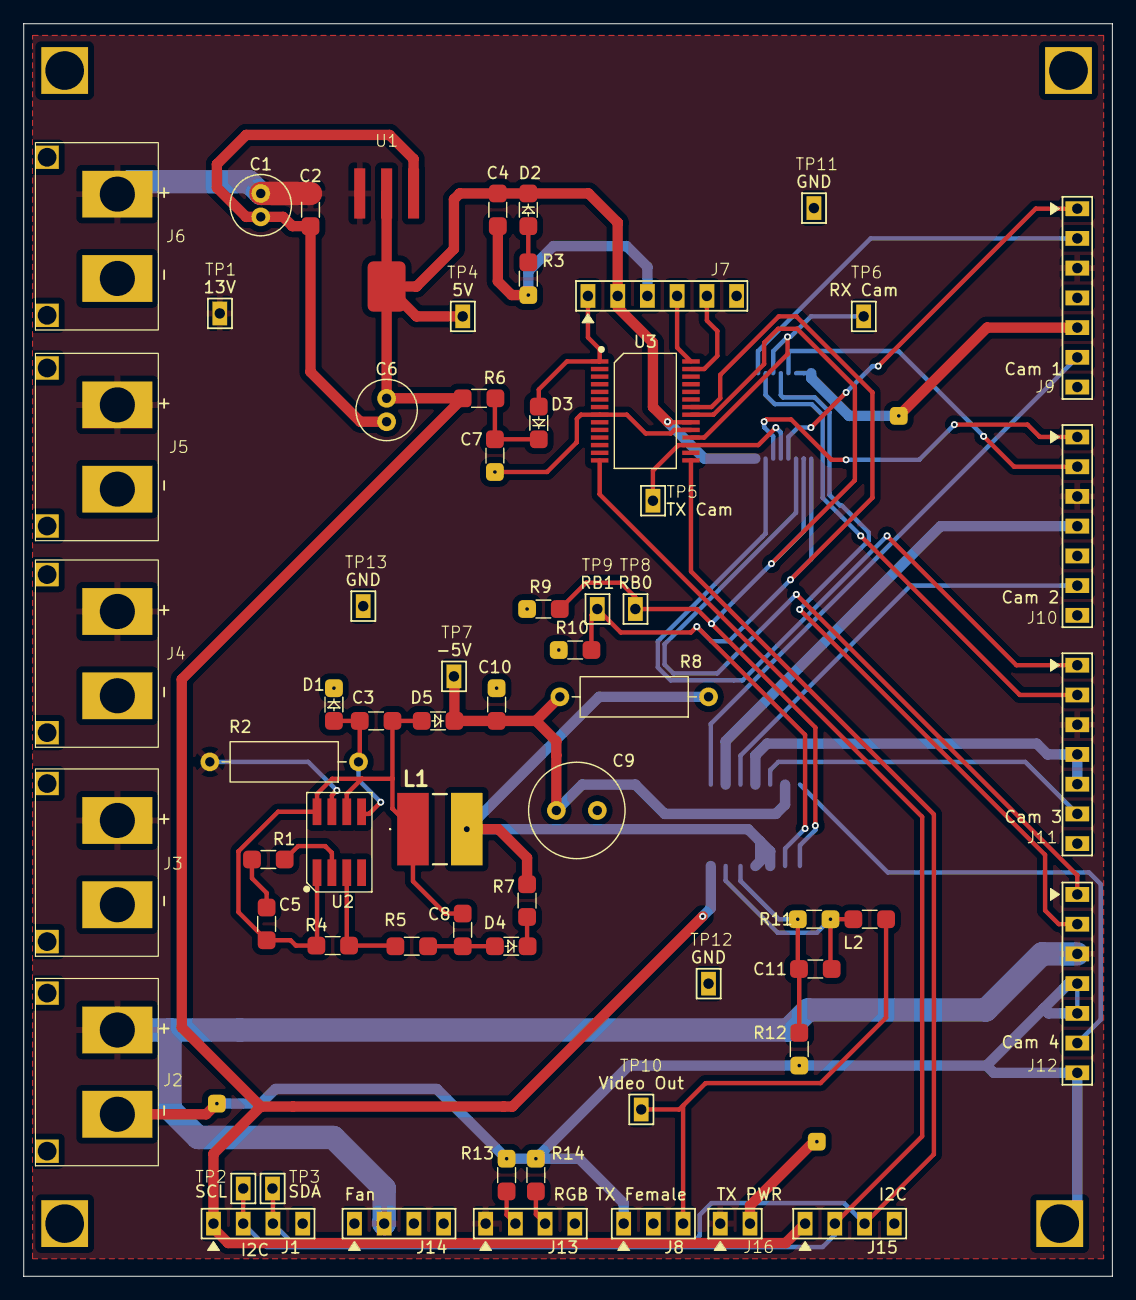
[picture p132: board ThermalCamera.kicad_pcb from above]

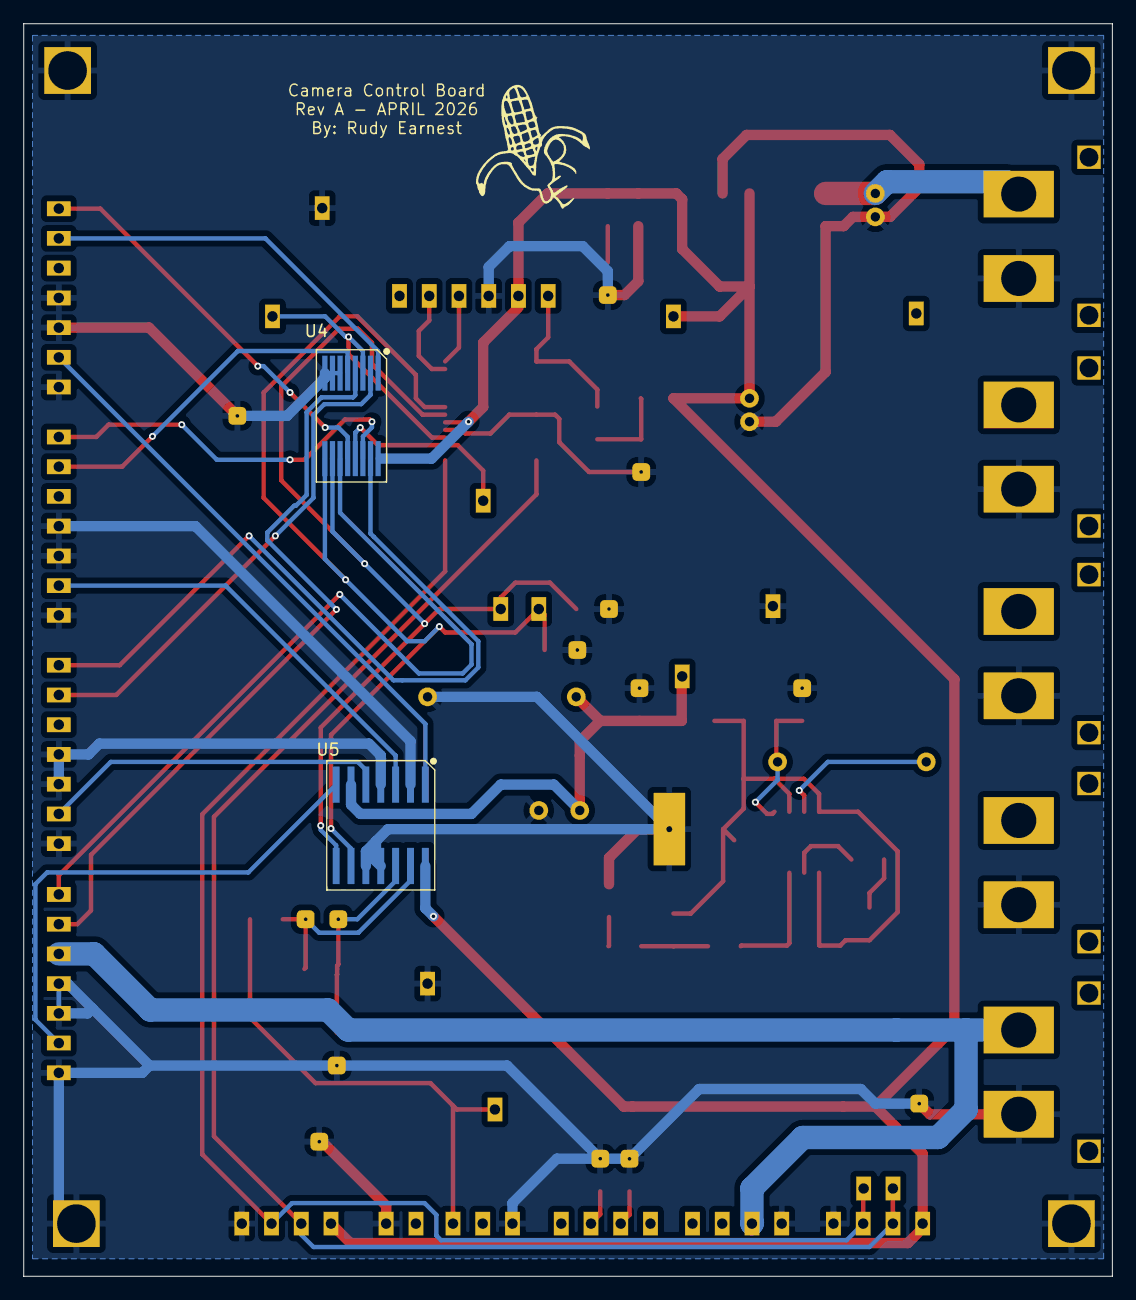
[picture p133: board ThermalCamera.kicad_pcb from below]

Board: 2 copper layers, 93.0 x 107.0 mm, 66 parts (2 on the bottom side), 39 nets.
