rc-earnest/BloodHound/(commit log)

2026-04-06 migrating existing camera files from old git repo
    [ThermalCamera.kicad_pcb, ThermalCamera.kicad_sch]
2026-04-08 working code for Slave Camera board reset doesn't work but has same byte string from last semester will investigate at a later date
    [Config.h, Inits.c, Main.c]
2026-04-14 Adding more to the KiCad schematic
    [ThermalCamera.kicad_pcb, ThermalCamera.kicad_sch]
2026-04-16 adding finished board schematic as well as PCB design
    [ThermalCamera.kicad_pcb, ThermalCamera.kicad_sch]
2026-04-20 adding kicad gerbers, PCB and final schematic for REV A
    [ThermalCamera-B_Cu.gbr, ThermalCamera-B_Mask.gbr, ThermalCamera-B_Paste.gbr, ThermalCamera-B_Silkscreen.gbr, ThermalCamera-Edge_Cuts.gbr, ThermalCamera-F_Cu.gbr, ThermalCamera-F_Mask.gbr, ThermalCamera-F_Paste.gbr]
2026-04-20 added comments to C Camera slave code to say what is happening
2026-04-27 Adding functionality to the zoom for the sony cameras to stop the zoom if it has started, also fixed the homing of the camera
    [ThermalCamera-B_Cu.gbr, ThermalCamera-B_Mask.gbr, ThermalCamera-B_Paste.gbr, ThermalCamera-B_Silkscreen.gbr, ThermalCamera-Edge_Cuts.gbr, ThermalCamera-F_Cu.gbr, ThermalCamera-F_Mask.gbr, ThermalCamera-F_Paste.gbr]
2026-04-28 Init C# WinForm for reading/parsing data from LiDAR
2026-04-28 Added simplified logic to enable/disable timer and controls; Added "safe" way to cleanly exit form and close Serial port(s) used
2026-04-28 Unable to store/read data currently, something wrong with one of those methods
2026-04-28 Restructuring; Starting to think that the timer idea wasn't the best...
2026-04-28 Working on stepping away from the timer idea and moving towards event-based handling for when data is received
2026-04-29 Program now shows data being received when tested with different device
2026-04-29 Copied sample log to main directory for ease of access
2026-04-29 Working on logic to convert and display relevant received LiDAR data
2026-04-30 Changed direction for the analog stick so flow aligns with what is seen on the receiver
    [ThermalCamera.step]
2026-04-30 reorganized the KiCad schematic for the camera a little bit
    [ThermalCamera.kicad_sch]
2026-04-30 Added reference log file for serial LiDAR data
    Intended to aid in showing what data was recorded with the C# program via USB/UART.
2026-04-30 Add designed LiDAR schematics and untracked files
2026-04-30 changing the master code to give the drive slave the correct information. This will need to be changed at a later date to also give the joystick buttons as this will be used for the headlights
2026-05-03 adding text to READ in camera folder
2026-05-06 adding all leftover changes
    [ThermalCamera.csv]
2026-05-07 Adding Aux sensors presentation, report and letter of transmittal
2026-05-07 Add files via upload
    Added Bloodhound Capstone report, Bloodhound BOM (excluding camera stuff), Master main schematic, Slave dev schematic, and Uni remote schematic
    [Bloodhound_BOM (1).xlsx]
2026-05-07 Add files via upload
    added report, bom, presentation, and all 3 board schematics
    [Bloodhound_BOM (1).xlsx]
2026-05-07 updated slave code to reflect final code
    [Bloodhound_BOM (1).xlsx]
